COSMOS-LYX/DuctANC/实验记录/20261110_205912_p4prep/report.md

# P4 准备：固件 0.3 已编译，第 2、3 步没有上板

日期：2026-11-10 20:59。喇叭没有出声，没有发 `TONE` / `NOISE` / `SWEEP`。声学上的 DAC→误差麦延迟（P2 的 5–6 个样本）这次没有测，那一步要喇叭响，等确认接线后再做。

## 做到哪一步

1. 编译和离线测试做完了。`firmware/hwtest` 的 debug 预设能链出 `hwtest.elf`。`host` 里 `pytest test_hwtest.py` 是 19 项通过；加上面那个 `XCHK` 拒绝之后又跑了一次，仍是 19 项通过。算法形式没有改：N=16，更新是减号，ε=1，二阶 80 Hz 因果高通的系数和 P3 同一组 float32 位型，Ŝ 用 `实验记录/20261110_175018_p2shat/shat.npz` 的 `h_err`，在上位机卷上高通冲激响应后截成 384 阶。开机 μ=0.002，γ=0，默认限幅 ±40 码。
2. 数值对账（同一段参考麦码、同一只 Ŝ_eff，上位机 x' 对固件回传的 x'）没有做。
3. 静音时的 CPU / 时序（`CLAMP 0`，ANC 开着但 DAC 停在中点，并在 `CAP` 回传时再读一次 `slip` / `lag_us`）没有做。

卡在链路上，不是卡在算法。

## 烧录

第一次 `cmake --build --preset debug --target flash` 成功：ST-LINK 序列号 37FF71064E57343665F41043，目标电压 3.27 V，器件 ID 0x413，下载 `hwtest.elf` 后校验通过，并做了软件复位。那一版就是当时源码，版本字符串 `duct-anc-hwtest-0.3`。

之后只加了一个口子：`XCHK` 在 ANC 已经开着时，先回 `ERR xchk anc on`，不再先读那一段二进制。源码重新编译通过（Flash 44500 B，RAM 45880 B，CCMRAM 64000 B）。再烧的时候 STM32CubeProgrammer 报 `No ST-Link detected`，用 `-l` 再看一次，ST-Link、J-Link、DFU 都是空的。所以芯片里现在仍是第一次校验通过的那一版；源码比芯片多这一个 `XCHK` 拒绝。第 2 步本来就会先 `ANC OFF` 再 `XCHK`，两版在这条路径上一样。

## 蓝牙

复位之后没有再对板子说过话。`python hwtest.py ports` 能看到口，但带真实蓝牙地址的口打不开：

| 口 | 结果 |
| --- | --- |
| COM16（此前用来传出的口，地址 58565FA3EC67） | 打开失败，信号灯超时（Win32 121） |
| COM8（CCFF9041D81F）、COM14（260909B603FA） | 同样是信号灯超时 |
| COM4 / COM7 / COM15 / COM17（地址全 0） | 本地能打开。对 COM4 发了一次 `PING`，没有返回，进程挂住后已结束 |

这是 SPP 没连上，不是固件没应答。`INFO` 里的版本字符串这次没有读到。

## 第 2、3 步准备好但没跑的内容

`host/anc_p4.py` 的 `both`：先 `ANC OFF`，再按 48 段把 Ŝ_eff 送上去并核对 CRC；用 `4_stand` 前 400 个参考麦码做 `XCHK`，和上位机同一套 float32 递推比最大绝对误差。然后 `CLAMP 0`、`MU 0.002`、`GAMMA 0`、`ANC ON`，连做三次 2000 帧带 DAC 的 `CAP`，每次前后读 `ANC STATUS`。通过条件是 `late=ovr=udr=slip=0`、`cpu` < 50%，并且每一格 DAC 码都是 2048。`cpu` 若一直是 0 而样本数在涨，记成 DWT 没在走，不当成占用率真是 0。`slip` 的门槛是 DAC 中断之后超过两个采样周期（250 µs）才把空出来的那一格写上；`late` / `udr` 仍保留，它们看不到「DAC 只是重复了旧码」这一种晚一拍。

这些数字这次都没有。

## 后面开环之前的操作顺序

保护用的开环基线是 ANC 关着时、误差麦高通后 50 ms RMS 的慢跟踪，门槛是它的 2 倍。基线会写在 `ANC ON` 和 `ANC STATUS` 的 `baseline=` 里。闭环时要先让手机的 200 Hz 响几秒，再 `ANC ON`。基线只有几 mV 时不要先开 ANC 再放手机，那 0.3 s 里保护会清 W。这次没有把「基线太小就拒绝 ANC ON」写进固件：第 3 步要在安静房间里开着 ANC、输出强制为 0 来量 CPU。

声学延迟要在喇叭可以响之后，用 `CAP` 多测几次。有时 5 有时 6 就先查时序，再谈降噪。`lag_us` 不能代替这个样本数。
