COSMOS-LYX/DuctANC/实验记录/20261110_210253_p4prep/report.md

# P4 第 1–3 步

固件 duct-anc-hwtest-0.3，端口 COM16。喇叭指令没有发。

这一次的 x' 误差不能用。上位机按 `\r\n` 发命令，固件读到 `\r` 就结束，把 `\n` 留在接收缓冲里。`XCHK` 接着把这个 `\n` 当成了第一个数据字节，400 个码整体错开 1 字节，所以回传的数到了 10^5。CPU 测试没跑成：下一次 `SHAT RST` 被剩下的那个字节粘成了未知命令。

## x' 对账

Ŝ_eff 校验 143A81AB。高通冲激响应留了 128 点（尾部能量 9.60e-07）。和在线 biquad 比，200 Hz 差 -0.0149 dB、+0.0054°。

400 点参考麦码：固件减上位机，最大绝对误差 5.259e+05，最大相对误差 1.583e+04，rms 2.537e+05。
