COSMOS-LYX/DuctANC/实验记录/20261110_210931_p4prep/report.md

# P4 第 1–3 步

固件 duct-anc-hwtest-0.3，端口 COM16。喇叭指令没有发。

## x' 对账

Ŝ_eff 校验 143A81AB。高通冲激响应留了 128 点（尾部能量 9.60e-07）。和在线 biquad 比，200 Hz 差 -0.0149 dB、+0.0054°。

400 点参考麦码：固件减上位机，最大绝对误差 0.000e+00，最大相对误差 0.000e+00，rms 0.000e+00。

## CPU 和时序（CLAMP 0，DAC 应保持 2048）

| 次序 | cpu % | lag_us | slip | late | ovr | udr | prot | baseline |
| --- | ---: | ---: | ---: | ---: | ---: | ---: | ---: | ---: |
| 0 | 35.1 | 10 | 0 | 0 | 0 | 0 | 0 | 162.17 |
| 1 | 35.8 | 12 | 0 | 0 | 0 | 0 | 1 | 162.17 |
| 2 | 34.1 | 12 | 0 | 0 | 0 | 0 | 1 | 162.17 |
| 3 | 34.1 | 12 | 0 | 0 | 0 | 0 | 1 | 162.17 |

| CAP | dac 不是 2048 的帧 | min | max |
| --- | ---: | ---: | ---: |
| 0 | 0 | 2048 | 2048 |
| 1 | 0 | 2048 | 2048 |
| 2 | 0 | 2048 | 2048 |

cpu 是两次 STATUS 之间最慢一拍占采样周期的百分比。lag_us 是 DAC 中断到任务写槽的最大时间，超过 250 µs 会计 slip。
这三次 CAP 串口在传数据。DAC 列如果出现不是 2048 的码，说明限幅没有把输出按在中点。
DAC 到误差麦的到达样本数这次没测：那要喇叭出声。`lag_us` 是任务把码写进 DMA 槽的时间，不能代替这个样本数。

## 怎么读这些数

x' 对上位机 float32 逐点相同，400 点里最大绝对误差是 0。这是同一套运算顺序对上了，不是放宽门槛之后才过。Ŝ_eff 的 CRC 是 143A81AB。高通截成 128 点再卷积，相对在线 biquad，200 Hz 差 −0.015 dB、+0.005°，这是系数近似，已经含在上面那次逐点比较里。

三次 CAP 期间串口都在传数据。最慢一拍 CPU 34%–36%，低于 50%。`lag_us` 是 10、12、12、12，`slip`、`late`、`ovr`、`udr`、`rxovf` 都是 0。三次写槽时间都在 12 µs 上下，没有出现有时一拍、有时两拍那种抖动。DAC 三列全部是 2048，喇叭指令没有发。

保护在第一次 CAP 回传之后锁上了。开 ANC 时基线已经是 162 mV（门槛 324 mV），不是几 mV。锁上之前误差麦 50 ms RMS 是 93 mV，200 Hz 是 14 mV；锁上时固件报的最后一窗是 493 mV，200 Hz 仍是 15 mV。存下来的三段各 0.25 s 里，误差麦 RMS 只有 80–85 mV，50 ms 窗都在 65–99 mV。493 mV 落在采完之后、串口把 12000 字节送出去的那一秒里，CAP 缓冲里没有这段波形。不确定是蓝牙发送时耦进误差麦，还是管子上真有一下冲击。阈值没有改。锁上之后 W 被清成 0，后面两段 CPU 仍含 384 点 FIR。

测完已经 `ANC OFF`，保护标志清掉，`CLAMP` 设回 40。结束时基线约 25 mV，误差麦 200 Hz 约 1 mV。闭环仍要先让手机的 200 Hz 响几秒，再 `ANC ON`。

板子上跑的是第一次校验烧进去的 0.3。`XCHK` 这次只以 `\n` 结尾。源码里已经让 getline 把 `\r\n` 收成一次换行，但 ST-Link 不在，这版还没烧进去。`实验记录/20261110_210253_p4prep` 是错位那一次，数字作废。
