COSMOS-LYX/DuctANC/实验记录/20261110_211546_p4prep/report.md

# P4 第 1–3 步

固件 duct-anc-hwtest-0.3，端口 COM16。喇叭指令没有发。

## x' 对账

Ŝ_eff 校验 143A81AB。高通冲激响应留了 128 点（尾部能量 9.60e-07）。和在线 biquad 比，200 Hz 差 -0.0149 dB、+0.0054°。

400 点参考麦码：固件减上位机，最大绝对误差 0.000e+00，最大相对误差 0.000e+00，rms 0.000e+00。

## CPU 和时序（CLAMP 0，DAC 应保持 2048）

| 次序 | cpu % | lag_us | slip | late | ovr | udr | prot | baseline |
| --- | ---: | ---: | ---: | ---: | ---: | ---: | ---: | ---: |
| 0 | 34.4 | 12 | 0 | 0 | 0 | 0 | 0 | 25.49 |
| 1 | 35.6 | 12 | 0 | 0 | 0 | 0 | 0 | 25.49 |
| 2 | 35.6 | 12 | 0 | 0 | 0 | 0 | 0 | 25.49 |
| 3 | 35.6 | 12 | 0 | 0 | 0 | 0 | 0 | 25.49 |

| CAP | dac 不是 2048 的帧 | min | max |
| --- | ---: | ---: | ---: |
| 0 | 0 | 2048 | 2048 |
| 1 | 0 | 2048 | 2048 |
| 2 | 0 | 2048 | 2048 |

cpu 是两次 STATUS 之间最慢一拍占采样周期的百分比。lag_us 是 DAC 中断到任务写槽的最大时间，超过 250 µs 会计 slip。
这三次 CAP 串口在传数据。DAC 列如果出现不是 2048 的码，说明限幅没有把输出按在中点。
DAC 到误差麦的到达样本数这次没测：那要喇叭出声。`lag_us` 是任务把码写进 DMA 槽的时间，不能代替这个样本数。

## 这次烧进去的是什么

ST-LINK 37FF71064E57343665F41043，3.29 V，下载校验通过并软件复位。芯片里现在有 getline 的修改：命令以 `\r\n` 结尾时，`\n` 不再留在接收缓冲里。上位机的 `XCHK` 已改回走普通的 `\r\n`。这次对账就是用 `\r\n` 做的，400 点最大误差仍是 0。`rxovf` 是 0。

静音时序和上一轮一致：CPU 34%–36%，写槽 12 µs，三次一样，`slip`/`late`/`ovr`/`udr` 都是 0，DAC 全是 2048。基线 25.5 mV，误差麦 23–30 mV，200 Hz 约 3 mV。三次 CAP 回传期间保护没有锁。上一轮那次 493 mV 没有复现；至少这一轮，串口送数本身没有把误差麦推过门槛。

`‖W‖` 从 0.14 增到 0.78。`CLAMP 0` 把输出按在中点，更新仍在跑，误差麦不是 0，所以 W 会慢慢长。这是开环，不是喇叭在响。`clamp_n` 一直在涨，是因为限幅为 0 时只要 y 不是整数 0 就算碰上。测完已经 `ANC OFF`，W 是 0。限幅已设回 ±40，状态行读到 `clamp=40.0`、`on=0`、`prot=0`。
