COSMOS-LYX/DuctANC/实验记录/20261110_212253_p4delay/report.md

# 作废的一次

只采完第一段，到达是 5，DAC rms 35.5 码，200 Hz 相干 0.973。第二段回传少了 2 个字节，尾部变成 `ND 03E9EA51`。当时已经 `STOP`。正式的三次在 `20261110_212446_p4delay`。
