COSMOS-LYX/DuctANC/实验记录/20261110_212446_p4delay/report.md

# DAC→误差麦到达样本

ANC 全程 OFF。激励 `NOISE 0.03`，和 P2 相同。每段 10666 帧，带 DAC。测完已 `STOP`。

Ŝ 的 `h_err` 用同一条规则（|h| 第一次超过峰值 30%）落在第 5 个样本。P2 记录里写的 5–6，是这个上升沿：第 4 点还只有峰值的 1.5%，第 5 点 32%，第 6 点 54%。

| 次 | 到达 | |h| 最大 | DAC rms | 200 Hz 相干 | cpu % | slip | late | ovr | udr | baseline |
| --- | ---: | ---: | ---: | ---: | ---: | ---: | ---: | ---: | ---: | ---: |
| 0 | 5 | 28 | 35.7 | 0.758 | 33.9 | 0 | 0 | 0 | 0 | 394.49 |
| 1 | 5 | 28 | 35.2 | 0.898 | 33.9 | 0 | 0 | 0 | 0 | 396.59 |
| 2 | 5 | 42 | 35.5 | 0.843 | 34.1 | 0 | 0 | 0 | 0 | 407.68 |

到达样本数：5、5、5。三次相同。

前 12 个系数（mV/码）：

- 第 0 次：-0.104 -0.064 +0.023 +0.079 +0.091 +0.570 +0.898 +1.052 +0.605 +0.533 +0.065 +0.183
- 第 1 次：+0.030 +0.058 +0.081 +0.048 +0.046 +0.461 +0.802 +0.990 +0.527 +0.590 +0.220 +0.358
- 第 2 次：+0.041 -0.007 -0.040 +0.031 +0.107 +0.489 +0.730 +0.999 +0.583 +0.581 +0.048 +0.119
- Ŝ：+0.007 +0.008 +0.008 +0.007 +0.023 +0.467 +0.799 +1.031 +0.568 +0.563 +0.145 +0.230

开噪声前：on=0 clamp=40.0 wnorm=0.0000 baseline=155.04 e200=20.28 cpu=33.4 slip=0 late=0 ovr=0 udr=0

计数器是累积值。cpu 是上一次 STATUS 之后最慢一拍占采样周期的百分比，所以每一行盖住这一次采集和回传。

STOP 后约 3 秒：on=0 wnorm=0.0000 clamp=40.0 baseline=205.68 prot=0 slip=0 late=0 ovr=0 udr=0 cpu=32.6。基线还在从噪声档往回落。又过了一会儿读到 baseline=155.65，和开噪声前的 155 一样。此时 err_rms=202，e200=21，on=0，out=OFF，slip=late=ovr=udr=0，cpu=32.6，lag_us=11。

没有发 `ANC ON`。

200 Hz 相干是 0.76、0.90、0.84。P2 那三段在 200 Hz 是 0.96–0.98。到达下标没有因此改变。第三次 |h| 的最大值从第 28 点移到第 42 点，上升沿仍在第 5 点。
