COSMOS-LYX/DuctANC/实验记录/20261110_213549_p4try/report.md

# 10 s 闭环试一次

开环：误差麦 200 Hz 192.46 mV，参考麦 200 Hz 43.72 mV，基线 205.64 mV。
允许范围是 153 mV、32 mV 的 ±20%，也就是 122–184 mV 和 26–38 mV。

没有打开 ANC。

误差麦比 153 mV 高 26%，参考麦比 32 mV 高 37%。两路一起偏高，比值 192/44 ≈ 4.4，P0 是 153/32 ≈ 4.8。紧接着又读了一次：误差麦 184 mV、参考麦 40 mV，仍在 ±20% 以外。基线 206 mV。on=0，prot=0，slip=late=ovr=udr=0。
