COSMOS-LYX/DuctANC/实验记录/20261110_214041_p4try/report.md

# 10 s 闭环试一次

开环：误差麦 200 Hz 5.96 mV，参考麦 200 Hz 2.21 mV，比值 2.70，基线 79.79 mV，保护门槛 159.58 mV。
通过条件：误差麦 100–260 mV，参考麦 25–60 mV，比值 3.8–5.8。

没有打开 ANC。误差麦 6.0 mV 低于 100 mV，参考麦 2.2 mV 低于 25 mV，比值 2.70 也低于 3.8。

紧接着又读了一次：误差麦 5.9 mV，参考麦 3.0 mV，基线 85 mV。on=0，prot=0，slip=late=ovr=udr=0。
