COSMOS-LYX/DuctANC/实验记录/20261110_214141_p4try/report.md

# 10 s 闭环试一次

开环：误差麦 200 Hz 195.86 mV，参考麦 200 Hz 43.02 mV，比值 4.55，基线 218.31 mV，保护门槛 436.62 mV。
通过条件：误差麦 100–260 mV，参考麦 25–60 mV，比值 3.8–5.8。

μ=0.005，γ=0，限幅 ±40。

| t / s | e200 | r200 | yrms | wnorm | clamp_n | prot | cpu | slip | late | ovr | udr |
| ---: | ---: | ---: | ---: | ---: | ---: | ---: | ---: | ---: | ---: | ---: | ---: |
| 0.07 | 186.24 | 46.30 | 7.56 | 0.0509 | 0 | 0 | 35.2 | 0 | 0 | 0 | 0 |
| 0.55 | 31.74 | 52.16 | 14.60 | 0.0567 | 73 | 0 | 34.5 | 0 | 0 | 0 | 0 |

0.55 s 时限幅计数从 0 增到 73，按约定立刻 `ANC OFF`。没有重试，参数没有改。没有跑满 10 s，上面两行不能取中位数当稳态。

开前误差麦 200 Hz 195.86 mV。关掉前最后一读 31.74 mV，低了 15.8 dB，出现在约 0.5 s。这一读没有再保持，所以不算稳态。prot=0，clamp_n=73，slip=late=ovr=udr=0。y rms 14.6 码，半秒里有 73 个样本碰到 ±40。

关掉之后：on=0，prot=0，W 已清零，e200 仍显示 31.74（0.25 s 窗还没换），baseline=223.15。
