COSMOS-LYX/DuctANC/实验记录/20261110_214925_p4run3/report.md

# μ=0.002 的 3 s

开环：误差麦 200 Hz 72.92 mV，参考麦 200 Hz 25.87 mV，比值 2.82，基线 366.56 mV，保护门槛 733.12 mV。

没有打开 ANC。误差麦 73 mV 低于 100 mV，比值 2.82 低于 3.8。参考麦 26 mV 落在 25–60 mV 里。基线 367 mV，门槛 733 mV。

关掉之后：on=0 prot=0 e200=72.92 baseline=370.56。
