COSMOS-LYX/DuctANC/实验记录/20261110_215257_p4demo/report.md

# 一次演示，没有预检、没有因限幅提前停

开环：误差麦 200 Hz 270.93 mV，参考麦 53.99 mV，基线 360.39 mV。
μ=0.005，γ=0，限幅 ±40。计划开 8 s。

| t / s | e200 | r200 | yrms | clamp_n | prot | cpu | slip | late | ovr | udr |
| ---: | ---: | ---: | ---: | ---: | ---: | ---: | ---: | ---: | ---: | ---: |
| 0.04 | 270.93 | 53.99 | 7.90 | 14 | 0 | 34.5 | 0 | 0 | 0 | 0 |
| 0.30 | 191.41 | 74.68 | 16.48 | 195 | 0 | 35.2 | 0 | 0 | 0 | 0 |
| 0.55 | 93.66 | 61.82 | 19.41 | 431 | 0 | 34.4 | 0 | 0 | 0 | 0 |
| 0.83 | 108.93 | 67.52 | 19.53 | 634 | 0 | 34.4 | 0 | 0 | 0 | 0 |
| 1.05 | 56.88 | 69.81 | 18.34 | 734 | 0 | 35.2 | 0 | 0 | 0 | 0 |
| 1.32 | 62.82 | 61.17 | 18.75 | 944 | 0 | 35.1 | 0 | 0 | 0 | 0 |
| 1.55 | 36.35 | 71.92 | 18.20 | 1090 | 0 | 35.2 | 0 | 0 | 0 | 0 |
| 1.80 | 43.30 | 71.05 | 17.73 | 1192 | 0 | 35.2 | 0 | 0 | 0 | 0 |
| 2.07 | 82.08 | 61.84 | 19.66 | 1427 | 0 | 35.2 | 0 | 0 | 0 | 0 |
| 2.30 | 86.67 | 58.93 | 19.43 | 1648 | 0 | 34.5 | 0 | 0 | 0 | 0 |
| 2.55 | 87.50 | 67.88 | 19.44 | 1828 | 0 | 35.2 | 0 | 0 | 0 | 0 |
| 2.81 | 75.55 | 64.20 | 20.13 | 2043 | 0 | 35.2 | 0 | 0 | 0 | 0 |
| 3.05 | 111.15 | 58.76 | 19.34 | 2273 | 0 | 35.2 | 0 | 0 | 0 | 0 |
| 3.31 | 55.94 | 68.70 | 16.72 | 2386 | 0 | 34.4 | 0 | 0 | 0 | 0 |
| 3.56 | 67.68 | 67.65 | 17.48 | 2561 | 0 | 35.2 | 0 | 0 | 0 | 0 |
| 3.83 | 82.58 | 60.46 | 18.82 | 2757 | 0 | 35.8 | 0 | 0 | 0 | 0 |
| 4.03 | 39.71 | 72.58 | 18.16 | 2965 | 0 | 35.2 | 0 | 0 | 0 | 0 |
| 4.30 | 52.97 | 79.61 | 18.65 | 3128 | 0 | 35.9 | 0 | 0 | 0 | 0 |
| 4.55 | 48.00 | 76.32 | 17.87 | 3403 | 0 | 35.2 | 0 | 0 | 0 | 0 |
| 4.80 | 47.59 | 70.80 | 19.72 | 3559 | 0 | 34.4 | 0 | 0 | 0 | 0 |
| 5.07 | 33.66 | 84.48 | 21.20 | 3774 | 0 | 35.2 | 0 | 0 | 0 | 0 |
| 5.32 | 115.90 | 58.43 | 17.74 | 4020 | 0 | 34.4 | 0 | 0 | 0 | 0 |
| 5.56 | 33.19 | 71.37 | 19.50 | 4223 | 0 | 35.2 | 0 | 0 | 0 | 0 |
| 5.82 | 67.64 | 75.96 | 17.12 | 4357 | 0 | 35.2 | 0 | 0 | 0 | 0 |
| 6.06 | 59.76 | 60.56 | 18.71 | 4552 | 0 | 35.9 | 0 | 0 | 0 | 0 |
| 6.28 | 85.96 | 60.67 | 20.71 | 4730 | 0 | 34.4 | 0 | 0 | 0 | 0 |
| 6.55 | 124.11 | 80.25 | 19.41 | 5002 | 0 | 34.4 | 0 | 0 | 0 | 0 |
| 6.81 | 33.06 | 72.78 | 22.27 | 5228 | 0 | 35.2 | 0 | 0 | 0 | 0 |
| 7.05 | 107.77 | 68.90 | 18.98 | 5431 | 0 | 34.5 | 0 | 0 | 0 | 0 |
| 7.31 | 55.33 | 69.42 | 20.87 | 5571 | 0 | 35.2 | 0 | 0 | 0 | 0 |
| 7.55 | 110.87 | 61.46 | 20.83 | 5725 | 0 | 35.2 | 0 | 0 | 0 | 0 |
| 7.83 | 84.11 | 63.95 | 19.22 | 5931 | 0 | 34.4 | 0 | 0 | 0 | 0 |
| 8.06 | 35.21 | 73.54 | 20.30 | 6084 | 0 | 34.4 | 0 | 0 | 0 | 0 |

末 2 s 的 0.25 s 读数在 33–124 mV 之间来回跳，中位数 84 mV，相对开前 271 mV 低 10.2 dB。最低的一窗是 33 mV（约 18 dB），没有停在那里。第一次低于开环 3 dB 是在约 0.3 s，之后又多次回到 100 mV 以上。

8 s 里限幅计数从 0 增到 6084，大约每 10 个样本有 1 个碰到 ±40，不是只在开头。开头 1.33 s 的 970 个也从 48 ms 分布到 1.30 s。y 的 200 Hz 分量是 8.5 码 rms；133、230、400 Hz 都在 0.6 码以下。这段频谱只覆盖开头 1.33 s。
末次 prot=0 clamp_n=6084 slip=0 late=0 ovr=0 udr=0 cpu=34.4。

开头 1.33 s 的 DAC：碰到 ±40 的样本 970 个。
第一个 48 ms，最后一个 1299 ms。

| 频率 | 这段 y 的 rms / 码 |
| ---: | ---: |
| 200 Hz | 8.51 |
| 133 Hz | 0.54 |
| 230 Hz | 0.51 |
| 400 Hz | 0.31 |

关掉之后 on=0 prot=0 e200=289.24。
