COSMOS-LYX/DuctANC/02_讨论记录.md

# 讨论记录

## 待决问题

| # | 问题 | 状态 |
| --- | --- | --- |
| Q1 | 学校的毕设任务书指标是什么？是否沿用课程设计的「100–400 Hz、≥10 dB、FreeRTOS、自画 PCB ≤100×100」 | 待确认 |
| Q2 | 原仓库 `COSMOS-LYX/duct-anc-stm32` 是否作为代码基础拉进本文件夹 | 待确认 |
| Q3 | 手头有哪些测量设备：声级计 / 测量麦 / 声卡 / 示波器 | 待确认 |
| Q4 | 「通风口」是否指真实场景（更大截面、更大风量），还是沿用 Φ75 实验管 | 待确认 |
| Q5 | 毕设加深项选哪几个（见 `01_设计评估.md` 第 3 节） | 待讨论 |
| Q6 | 时间节点：开题、中期、答辩日期 | 待确认 |

## 决策记录

| 日期 | 决策 | 理由 |
| --- | --- | --- |
| 2026-11-08 | 以原课程设计架构（STM32F407 + FxNLMS 前馈）为基础 | 架构核对成立，见评估第 1 节 |
| 2026-11-08 | 控制板用 F407VET6 黑色最小系统板，固件用 StdPeriph 标准库 + FreeRTOS，CMake + CubeCLT GCC 编译 | 用户指定；本机只装了 CubeCLT |
| 2026-11-08 | 上位机通信走 JDY-31 蓝牙 SPP（USART1 PA9/PA10，9600） | 用户指定；采集原始数据受 9600 限制，可改 115200 |
| 2026-11-10 | 蓝牙改 115200：固件开机时在未连接状态下用 AT 指令自动把 JDY-31 从 9600 改成 115200 | 4000 帧采集从 17 s 降到约 1.5 s；不需要 USB-TTL |
| 2026-11-10 | 初级噪声源改用外部声源（手机外放），不再用风扇；第一阶段目标：误差麦处 200 Hz 单音衰减 ≥10 dB | 手机单音频率稳定、可复现；此前记录里「风扇」段实际是否开过风扇已无法确认 |
| 2026-11-10 | 第一阶段继续用参考麦。200 Hz 回路放大倍数 0.34 | 抵消档回流 10.8 mV，手机在参考麦上 32 mV。最坏同相叠加约 1.5 倍。见 `实验记录/20261110_173557_fb200` |
| 2026-11-10 | P4 的控制只动 200 Hz 附近：参考先窄带通，或控制抽头别太多 | 单音任务。Ŝ 在 133 Hz 和 232 Hz 各有一峰，350 Hz 是深凹陷，宽带自由适应会碰到变化很大的次级路径 |
| 2026-11-10 | Ŝ 用 17:00 三段白噪声、384 阶、单位 mV/DAC 码 | 留出验证的带内 NMSE 约 −18 dB，三段冲激响应互差约 −31 dB，并能预测随后的 200 Hz 单音。见 `实验记录/20261110_175018_p2shat` |
| 2026-11-10 | 这一阶段的相干合格线改成 200 Hz 附近 >0.9 | 100–400 Hz 平均只有 0.84，被 350 Hz 推不动的那段拉低；200 Hz 本身是 0.98 |
| 2026-11-10 | 现在这只 Ŝ 不含 80 Hz 高通；P4 烧录前要和固件用同一只因果高通 | 回归只去了直流。二阶 Butterworth、80 Hz、8 kHz 在 200 Hz 有 +34°，一阶是 +22° |
| 2026-11-10 | P4 控制器先用 N=16、μ=0.005、γ=0、二阶 80 Hz 因果高通并卷进 Ŝ，DAC 限幅 −2048…2047 | 离线仿真在回流、高通、整数量化都加上之后，200 Hz 长时拟合约 −48 dB、0.25 s 窗约 −31 dB，0.4 s 收敛。μ=0.015 起顶满 DAC。见 `实验记录/20261110_195059_p3sim` |
| 2026-11-10 | 固件 0.3 按这个形式逐样本跑 FxNLMS；开机 μ=0.002、限幅 ±40；喇叭先不开 | 第 1 步编译和 pytest 已过，第一版已校验烧入。x' 对账和静音 CPU 还没做，蓝牙和 ST-Link 随后都断开了。见 `实验记录/20261110_205912_p4prep` |
| 2026-11-10 | 第 2、3 步按实测收：x' 逐点相同，静音时 CPU 约 35%，写槽约 12 µs；喇叭仍不开 | 400 点最大误差是 0。三次 CAP 期间 slip/late/ovr/udr 都是 0，DAC 全是 2048。保护在回传时锁上过，阈值没改。见 `实验记录/20261110_210931_p4prep` |
| 2026-11-10 | `\r\n` 由固件收成一次换行，这版已烧进芯片 | 否则 `XCHK` 会把 `\n` 当成数据，码错开 1 字节。烧入后用 `\r\n` 复测，误差仍是 0。见 `实验记录/20261110_211546_p4prep` |

## 讨论日志

### 2026-11-08

- 建立讨论文件夹，完成第一版架构评估。
- 评估要点：高风险是相干性、声反馈、风扇旁路辐射/测量方法；中风险是抗混叠、因果余量、驻波、功放增益匹配。
- 建议第一个实验：风扇开、ANC 关，录参考麦和误差麦，计算 100–400 Hz 频谱与相干函数。
- PVC 管实验平台已搭好（参考麦 → 扬声器 → 误差麦）。
- 新建 `firmware/hwtest` 基础硬件测试固件和 `host/hwtest.py` 上位机：蓝牙 PING、扬声器单音/噪声/扫频、麦克风电平与原始数据采集、一键自检。编译通过（Flash 36 KB，RAM 38 KB，CCM 64 KB 采集缓冲），上位机用模拟固件离线测试通过，**尚未上板**。
- 上板后用 `capture` 在风扇开时采一段，就能得到建议的第一个实验（频谱 + 相干函数）。
- 首次上板自检（`实验记录/20261108_165459_selftest`）：蓝牙、时钟、ADC/DAC 正常。发现两个硬件问题：
  1. err 通道 ≈ 0.69×ref + 356，相关 0.996、滞后 0 样本、全频段相干≈1 → 不是声音，是 PC1 悬空时 ADC 扫描串扰（误差麦没有真正接到 PC1）。
  2. ref 麦在「静音」段也在 0~4095 之间满幅削波，主要成分 128/324 Hz → 麦克风饱和（风扇开着、增益过高或气流直吹）。
- 自检脚本加入「静音电平」「两路独立」两项检查和关风扇提示。
- 喇叭嗡嗡声：PAM8403 的 MUTE/SHDN 接 VCC、INR 接地后，换成稳定电源，嗡嗡声明显减小，用户认为可以接受。后续若影响降噪下限再处理（单独供电 + 输入分压）。
- 首次 mictest（`实验记录/20261108_184511_mictest`）：
  - 通道顺序和几何正确：GCC-PHAT 测得喇叭声 err 比 ref 早 4 样本（应 3），风扇声 err 晚 8 样本（应 10，约 343 mm）。敲击测试的 FAIL 是指标设计问题（按相对 dB 比较，本底高的 ref 天然吃亏），改为绝对增量并降为参考项。
  - 喇叭白噪声 amp 0.1 时两只麦都削波 → 两只麦对管内平面波灵敏度相近（100–400 Hz 分别 1279/1084 mV）。mictest 默认 amp 改为 0.02。
  - **「静音」和「风扇」两段几乎一样**：ref 在 100–400 Hz 分别 79/83 mV，err 11/10 mV，主峰都是 125 Hz 和 320 Hz。要么第 1 步风扇没真正断电，要么这只风扇在 100–400 Hz 几乎不出声，待确认。
  - ref 的 125/320 Hz 比 err 高约 18 dB，而对喇叭声两只麦灵敏度相近 → 这部分不是沿管道传播的平面波，是 ref 麦附近的局部干扰（风扇近场/湍流/振动，或电气耦合），γ²≈0.5 也与此一致。
  - err 有 4–30 Hz 的次声成分（约 25 mV），在目标频段之外，不影响 ANC。
- 第二次 mictest（`实验记录/20261108_190027_mictest`）：
  - 喇叭白噪声 amp 从 0.1 降到 0.02（−14 dB）：err 100–400 Hz 从 1084 降到 390 mV（正常），ref 仍然削波（1192 mV）。声程差变成 err 比 ref **晚** 10 样本，与几何相反。解释：喇叭信号以电气方式直接耦合进 ref 麦电路（零延迟），err 收到的是走管道的声音（约 0.7 ms 加喇叭延迟）。
  - ref 静音时 125/320 Hz 约 81 mV，err 只有约 8 mV → 同一来源：功放残余噪声电气耦合进 ref（地线共用或走线挨着喇叭线/功放）。
  - 风扇在 100–400 Hz 很弱：开风扇后 err 只从 8 mV 升到 11 mV（风扇本身约 7.5 mV），比 amp 0.02 的喇叭声低约 34 dB。待确认风扇供电电压。
- 新增 `hwtest.py mictest` 麦克风专项测试：本底噪声 → 敲击定位 → 扬声器白噪声 → 风扇噪声，输出信噪比、削波、相干性（降噪上限）和 GCC-PHAT 声程差（核对通道和几何）。

### 2026-11-10

- 功放改电池单独供电，开发板和麦克风留在 USB 上，地线单点连接，之后参考麦底噪明显下降（`实验记录/20261109_170228_mictest`）。
- 那次的「3_fan」段实际是**手机外放 200 Hz 单音**；之前记录里的「风扇」段有没有真的开风扇，已经记不清。之后统一改用外部声源。
- 复核 `20261109_170228_mictest`：
  - 单音频率实测 199.95–200.07 Hz，两麦相干 1.00；400 Hz 处相干 0.96。脚本给出的「平均相干 0.26」把没有信号的频点也平均进去了，不能用。
  - 200 Hz 处参考麦比误差麦高约 25 dB（49.9 vs 25.0 dB），而喇叭白噪声下两麦灵敏度相近 → 手机离参考麦太近，参考麦在近场。参考麦 rms 776 mV，600 Hz 三次谐波只比基波低 17.6 dB，可能是手机喇叭失真或参考麦接近饱和。
  - 单音每 5 ms 重复一次，GCC-PHAT 给出的「0 样本」延迟没有意义。
  - 误差麦 80 Hz 以下 rms：静音 24 mV，播放单音时 167 mV，约占误差麦总能量的 88%（80 Hz 二阶高通后总 rms 从 179 mV 降到 63 mV）。疑似来源：手机碰管/手扶的振动、短音频循环处的咔哒声、管口气流扰动，待对照。
  - 喇叭白噪声 amp 0.02 时参考麦仍削波 38%，延迟 +9 而非 −3，与 11-08 的「喇叭驱动电耦合进参考麦」判断一致，尚未排除。
- 固件现状对后续的影响：
  - `CAP` 不记录 DAC 输出，噪声发生器自由运行，离线辨识 Ŝ 前需要同步录 DAC。
  - `AUDIO_BLK = 128`，ADC→DAC 有 128–256 样本（16–32 ms）延迟。对单音可以接受，Ŝ 必须覆盖这段延迟；宽带 ANC 必须改成小块处理。
  - 误差信号加高通时，用高通后的误差麦数据辨识 Ŝ，让 Ŝ 自带高通。
- 下一步：
  - P0：手机用支架固定、不碰管、音量降到参考麦 rms 200–300 mV，播放长的无缝音频；做贴管/不贴管、播放静音文件两组对照，查低频脉冲来源；喇叭降到不削波后拔线对照，确认参考麦电串扰。
  - P1：`CAP` 增加 DAC 通道（可选：波特率提到 115200）。
  - P2：离线辨识 Ŝ。
  - P3：Python 离线仿真 FxLMS。
  - P4：固件 200 Hz FxLMS（小块处理、80 Hz 高通、32 抽头 NLMS、泄漏、限幅、发散保护）。
  - P5：ANC 开/关交替验收。
- 第一次 p0test（`实验记录/20261110_102735_p0test`）：
  - 参考麦电串扰排除：拔喇叭线 / 关功放后两路 300 Hz 都掉到本底（ref −57 / −60 dB）。11-08 的「喇叭驱动电耦合进参考麦」不成立，ref 削波和 +9 延迟是声学原因。
  - 4–6 段出现与固件 128 样本块（16 ms）同步的跳变 + 800 Hz（fs/10）谐波，0–3 段没有，出现在「恢复功放和喇叭接线」之后。11-08 最早几次记录里也有同样的同步干扰。判断为接线/地线接触相关，不是手机。p0test 已加「MCU 同步干扰」检查（块内位置折叠 |diff|，边界/其余 ≥2 倍判定）。
  - 手机音量过大（ref 990 mV 削波），声源段数据作废。
- 麦克风模块对调（`实验记录/20261110_121744_p0test`）：只对调两块 MAX4466 模块，线不动（PC0 仍是参考位置）。记原参考位置那块为 M1，原误差位置那块为 M2。
  - 喇叭 300 Hz 的 ref−err：对调前 +22.5 dB，对调后 −16.0 dB。由两次各自的两路比值算出：**M1 比 M2 灵敏约 19 dB**（模块本身），参考位置比误差位置多收约 3 dB（位置）。本底差值也跟着模块走（+19 → −20 dB）。
  - 低频也跟着 M2 走：静音段 80 Hz 以下，M2 在误差位置时 26.6 mV、在参考位置时 18.5 mV；M1 在两处都约 3 mV。M2 增益低 19 dB 却低频大 8 倍，M2 模块（或它的接头）本身有问题。
  - 同步干扰这次消失（重新插过杜邦线），进一步说明与接触/接线有关。
- 决策：保持对调后的布置——M2（低灵敏度、低频噪声大）作参考麦，M1（高灵敏度、低频干净）作误差麦。参考麦不再容易削波，误差麦分辨率更高、低频干净，利于自适应。之后不再动麦克风、功放音量和接线；有新模块时换掉 M2。
- 对调后重测外部声源（`实验记录/20261110_154011_p0test`，`--ref-target 80 200`）：
  - 无削波、无同步干扰；200 Hz 两麦相干 1.00。单音 ref 32 mV、err 153 mV；err 200 Hz 本底 4.1 mV → 可测降噪上限约 31 dB。
  - err 相对 ref +10.6 样本（模 40），与几何 428 mm ≈ 10.0 样本一致：参考麦领先误差麦约 1.3 ms。宽带 ANC 时这点余量远小于固件 16–32 ms 的块延迟，必须改小块；200 Hz 单音不受影响。
  - err 低频（<80 Hz）只有 2.5–7.9 mV（对调前 167–456 mV），误差麦低频问题已解决。脚本对此报 WARN 是相对比较的误报，绝对值比单音低 26 dB。
  - ref（M2）低频：静音 25 / 支架 52 / 贴管 262 mV（6–16 Hz）。M2 对振动很敏感，实验时不能碰管；参考通道必须加高通。调音量时 LEVEL 显示的 ref 78–198 mV 主要是这部分低频，单音本身只有 32 mV。
  - 3 次谐波 ref −27 / err −23 dB，两麦都没削波 → 手机喇叭失真。只针对 200 Hz 的 ANC 不受影响，但验收时要按 200 Hz 线谱算，不按总声级。
  - 结论：P0 完成，外部声源可用。手机保持这次的位置和音量。
- P1 完成：固件 0.2 的 `CAP n D` 同步采 DAC 输出（与 ADC 逐帧对齐，最多 10666 帧），上位机 `capture --dac`。
  - 对齐验证（`实验记录/20261110_162327_sid`，NOISE 0.01）：DAC→err 到达 5–6 样本、DAC→ref 8 样本，与 238/366 mm 声程一致，相差 3 样本。
  - NOISE 0.03 连采 3 次（`..._sid_a/b/c`）：误差麦 100–400 Hz 比静音高约 19 dB；DAC→err 相干 100–300 Hz 为 0.88–0.99，200 Hz 为 0.96–0.98。三次冲激响应（xcorr 粗估 256 抽头）互差 −17～−20 dB；Ŝ(200 Hz) 幅度 19.5–24.7 mV/码、相位 −19～−26°。
  - 325–400 Hz 是 Ŝ 的凹陷：350 Hz 处 |Ŝ| 约 1.1 mV/码，比 200 Hz 低约 27 dB，激励加大也没用（喇叭推不动误差麦位置），这个频段无法控制。
  - DAC→ref 相干只有 0.4（200 Hz 为 0.5），而参考麦带内比静音高约 19 dB → 参考麦（M2）在喇叭工作时收到大量与激励不相干的成分，同时 80 Hz 以下涨到 140–180 mV。推测是喇叭带动管壁振动，M2 对振动敏感且响应非线性。会影响 ANC 时参考信号的质量，待处理（M2 用软垫减振安装，或者换新模块）。
- 回流（`实验记录/20261110_173557_fb200`）：手机停，喇叭单独放到误差麦 153 mV 时，参考麦 200 Hz 为 10.8 mV。相对手机放声时的参考麦 32 mV，圈的放大倍数 0.34。两档严格成比例。参考麦比误差麦晚 1.8 个样本，是声音往上游走。最坏同相叠加 \(1/(1-0.34)\approx 1.5\) 倍。
- P4 先限制在 200 Hz 附近。227–234 Hz 的管共振是担心，不是回流已经测到的事实；上板后看误差麦频谱会不会在 230 Hz 附近冒尖。
- P2 完成（`实验记录/20261110_175018_p2shat`）：17:00 的三段 NOISE 0.03 做 384 阶最小二乘。Ŝ(200 Hz) = 25.5 mV/码、−21°。留一段验证，100–400 Hz NMSE 约 −18 dB；三段冲激响应互差约 −31 dB。用这只 Ŝ 预测随后的 200 Hz 单音：153 mV 实测，157 mV 预测，相位差 0.2°。|Ŝ| 在 133 Hz 和 232 Hz 各高约 3 dB，350 Hz 低 35 dB。控制抽头可以短，Ŝ 本身要留这 384 阶，尾巴是管子在响。
- 辨识回归没有做 80 Hz 高通，只对 DAC 码和误差麦各自减了直流。带内 NMSE 用的 100–400 Hz 带通是事后打分，零相位，没有写进系数。DAC→误差麦相干，100–400 Hz 平均 0.84，180–220 Hz 平均 0.97–0.98，200 Hz 为 0.975–0.986。合格线改为 200 Hz 附近 >0.9。
- 上板前 Ŝ 要和 P4 的因果高通对齐：8 kHz 采样、截止 80 Hz 的 Butterworth，200 Hz 处一阶相位 +21.8°（幅度 −0.6 dB），二阶 +33.9°（幅度 −0.1 dB）。用 `filtfilt` 对齐会把相位消掉，不算数。
- P3 离线仿真（`实验记录/20261110_195059_p3sim`），没上板、没改固件。20 s 的 x、d 是按 `4_stand` 的 200/600 Hz 和残差谱合成的，没有把短录音首尾接起来。合成的 200 Hz 和录音对得上：ref 32.0/32.1 mV，err 152.7/149.8 mV，延迟 10.64/10.67 样本。
- 推荐这一组：N=16，μ=0.005，γ=0，二阶 80 Hz 因果高通并卷进 Ŝ，DAC 限在 −2048…2047。4 s 正弦拟合 −47.6 dB，0.25 s 窗中位数 −31.4 dB，收敛 0.38 s。y rms 7.3 码，没有碰到限幅。合格线达到。逐项对比固定在 μ=0.01，二阶对齐再加量化已经是 −47.6/−32.9 dB、0.76 s，不是把 μ 调到边界才过的。
- μ 扫描里稳定的只有 0.005 和 0.01。0.015 起，末尾 4 s 输出一直顶在 DAC 上。上界在 0.01 和 0.015 之间，没有更密的点。N=4 发散。N=8 是 −28.8/−27.5 dB、0.30 s。N=32 的短时窗和 N=16 一样，都是 −32.9 dB。
- 量化对 200 Hz 线几乎没有影响（二阶对齐 −47.9，量化后 −47.6）。
- 不加高通、N=16、μ=0.01 时仿真发散。这不能当成管子一定会叫：F 只在 200 Hz 测过（1.73 mV/码，晚 4.15 样本），仿真把同一个增益用到了全频带，而 |S| 在 10 Hz 只有 0.078 mV/码。二阶高通即使没卷进 Ŝ 也能把这档稳住。一阶高通必须卷进 Ŝ，否则同一档 μ 发散。
- 给 Ŝ 加相位（只在 200 Hz 准确）：+75° 仍有 −39 dB，+90° 只剩 −16 dB，−90° 发散。
- 贴管 6–16 Hz：Welch 算参考麦 244 mV。上面写的 262 mV 是窄带 IIR，会把 200 Hz 漏进这个带。冲击只加在参考麦上。归一化步长没有被压短（1/(‖x'‖²+ε) 约 8.7×10⁻⁸，和无冲击一样）。二阶高通下 200 Hz 仍是 −47/−31 dB。没有高通时 y rms 升到 32 码，单音还在降。不确定真实碰管子时误差麦吃进多少，这段录音里误差麦 6–16 Hz 只有 0.8 mV。
- 副作用（Welch）：133 Hz +6.2 dB，230 Hz +7.1 dB，400 Hz 不变。100–400 Hz 总能量 −9.8 dB。230 Hz 抬高了，绝对高度仍低于关环时的 200 Hz 线。F 在 230 Hz 没有测过，所以上板后还要再看。
- 保护是仿真里定的，不是测到的：误差麦 50 ms rms 连续 4 窗高于开环 rms 的 2 倍，就清零 W 并静音。推荐参数开着保护不会误触发。相位反过来或 μ×10，0.20 s 切断。
- P4 固件 0.3（`实验记录/20261110_205912_p4prep`）：逐样本 FxNLMS，Ŝ 用 `shat.npz` 的 `h_err`，高通在上位机卷进 384 阶后下发。开机 μ=0.002、γ=0、限幅 ±40。`pytest` 19 项通过。第一版经 ST-Link 校验烧入并复位。随后只加了「ANC 开着时 `XCHK` 直接拒绝」，重烧时已经没有 ST-Link，芯片里仍是第一版。
- 第 2 步（固件回传的 x' 对上位机）和第 3 步（`CLAMP 0`、三次 `CAP` 时的 `slip`/`cpu`）没有做。COM16、COM8、COM14 打开都是信号灯超时，SPP 没连上，版本字符串没读到。没有发单音、噪声或扫频。
- 闭环时的顺序：手机的 200 Hz 先响几秒，再 `ANC ON`。基线是 ANC 关着时估的，门槛是它的 2 倍；基线写在状态行的 `baseline=` 里。没有用「基线太小」去锁住 `ANC ON`，因为静音 CPU 测试也要开着 ANC。
- 晚一拍不一定进 `late`/`udr`：DAC 重复旧码不算欠载。固件另有 `slip`，门槛是中断后超过两个采样周期（250 µs）才写上。声学上的 5–6 个样本要等喇叭可以响之后用 `CAP` 多测几次，`lag_us` 不能代替。
- 第 2、3 步（`实验记录/20261110_210931_p4prep`）：COM16 通。400 点 x' 和上位机 float32 逐点相同，最大误差 0，CRC 143A81AB。`CLAMP 0` 下三次带 DAC 的 CAP，码全部是 2048。CPU 34%–36%，`lag_us` 10–12，`slip`/`late`/`ovr`/`udr`/`rxovf` 都是 0。三次写槽时间一样，没有一拍、两拍来回跳。
- 第一次对账作废（`实验记录/20261110_210253_p4prep`）。命令以 `\r\n` 结尾时，固件读到 `\r` 就返回，`\n` 留在缓冲里，被 `XCHK` 当成数据，400 个码错开 1 字节。上位机对 `XCHK` 改成只发 `\n` 之后，误差变成 0。源码里 getline 会把配对的 `\r\n` 吃掉，ST-Link 不在，这版还没烧进芯片。
- 保护在第一次 CAP 回传后锁上。当时基线 162 mV，门槛 324 mV。锁上时固件报的 50 ms 窗是 493 mV，200 Hz 仍是 15 mV；存下的 0.25 s 里误差麦只有约 80 mV。493 mV 发生在串口送数的那一秒，缓冲里没有这段波形。不确定是蓝牙耦进去还是管子上有冲击。阈值没改。测完已关 ANC，限幅设回 ±40。结束时基线约 25 mV。
- 声学上的 5–6 个样本这次仍没测。闭环前先让手机的 200 Hz 响几秒，再 `ANC ON`。
- 换行修复已烧入并复测（`实验记录/20261110_211546_p4prep`）。`XCHK` 改回 `\r\n`，400 点最大误差仍是 0，`rxovf` 是 0。CPU 34%–36%，写槽三次都是 12 µs，`slip`/`late`/`ovr`/`udr` 都是 0，DAC 全是 2048。基线 25.5 mV，回传期间保护没有锁，上一轮的 493 mV 没有复现。测完 ANC 关，限幅回到 ±40。
- DAC→误差麦到达（`实验记录/20261110_212446_p4delay`）：ANC 保持关，`NOISE 0.03`，三段各 10666 帧。到达都是 5 个样本，和 Ŝ 的上升沿一致（第 4 点仍远小于峰值，第 5 点跨过 30%）。DAC rms 35–36 码，和 P2 相同。测量期间 cpu 约 34%，slip/late/ovr/udr 都是 0。测完已 STOP。200 Hz 相干 0.76/0.90/0.84，低于 P2 的 0.96–0.98。开噪声前基线已经是 155 mV，静下来之后仍是 156 mV。没有开 ANC。
- 10 s 闭环没有做（`实验记录/20261110_213549_p4try`）。手机已放 200 Hz。ANC 关着时误差麦 192 mV、参考麦 44 mV，基线 206 mV。相对 P0 的 153 mV、32 mV 高出 26% 和 37%，超过 20%。没有开 ANC。
- 放宽预检后再读（`实验记录/20261110_214041_p4try`）：误差麦 6.0 mV，参考麦 2.2 mV，比值 2.70，基线 80 mV，门槛 160 mV。两路都不在 100–260 / 25–60，比值也不在 3.8–5.8。没有开 ANC。
- 手机开声后的 10 s 试跑（`实验记录/20261110_214141_p4try`）在 0.55 s 停下。开环误差麦 196 mV、参考麦 43 mV、比值 4.55、基线 218 mV、门槛 437 mV。μ=0.005，γ=0，限幅 ±40。0.55 s 时误差麦 200 Hz 到 32 mV，同时限幅计数到 73，立刻关掉。没有跑满，32 mV 不算稳态。prot=0，slip/late/ovr/udr=0。没有重试。
- μ=0.002 的 3 s 没有做（`实验记录/20261110_214925_p4run3`）。误差麦 73 mV、参考麦 26 mV、比值 2.82、基线 367 mV。误差麦低于 100 mV，比值低于 3.8。没有开 ANC。固件加了 `CARM`/`CGET`，采集可以在后台进行；这次没用上。
- 放开预检和限幅停止，μ=0.005 开了 8 s（`实验记录/20261110_215257_p4demo`）。开前误差麦 271 mV。末 2 s 的 0.25 s 窗在 33–124 mV 之间，中位数 84 mV，约 10 dB。约 0.3 s 就低于开环 3 dB，之后没有稳住。限幅 8 s 里碰到 6084 次，全程都有，不是只有开头。prot=0，slip/late/ovr/udr=0，CPU 约 35%。关掉后误差麦回到 289 mV。
