COSMOS-LYX/DuctANC/01_设计评估.md

# 总体设计架构评估

评估对象：`00_原始资料/总体设计架构.md`（2026-11-08 版）。
结论先行：**架构方向正确，可以作为毕设的基础**。前馈 + FxNLMS + 白噪声离线辨识次级路径、采样中断不进 RTOS，这些是管道 ANC 的标准做法，数字和引脚基本自洽。主要风险不在算法，而在**声学与测量**：参考/误差麦的相干性、声反馈、风扇机壳的旁路辐射、抗混叠不足。另外原文档是「课程设计」深度，作为毕设需要再加一两块有研究含量的内容。

---

## 1. 核对过、成立的部分

| 项目 | 核对结果 |
| --- | --- |
| 平面波假设 | 内半径 35 mm，\(f_c = 1.841c/(2\pi a) \approx 2.87\) kHz（按 35.5 mm 约 2.83 kHz）。100–400 Hz 远低于截止，一维模型成立 |
| 因果余量 | 参考麦→三通轴线 278 mm（0.81 ms）；纸盆→轴线 88 mm（0.26 ms）+ 电延迟 0.20 ms = 0.46 ms。余量 0.35 ms，与原文 354 μs 一致 |
| 算力 | 每拍约 96（W 滤波）+ 160（Ŝ 滤波）+ 96（更新）≈ 350 次乘加，×8 kHz ≈ 2.8 M MAC/s，F407 168 MHz 带 FPU 占用不到 5% |
| 引脚 | PC0/PC1 = ADC123_IN10/11，PA4 = DAC_OUT1，ADC1 用 DMA2 Stream0，TIM2_TRGO 可触发 ADC1，USART1 = PA9/PA10，I2C2 = PB10/PB11，均与 F407 手册一致 |
| Flash | VET6 512 KB，扇区 7 起于 0x08060000（128 KB），程序限前 384 KB，正确 |
| RTOS 划分 | DMA 中断优先级 1 高于 `configMAX_SYSCALL_INTERRUPT_PRIORITY` 且不调内核 API，这是对的；滤波器不放任务里，避免调度抖动 |
| 辨识方法 | 风扇关、注入白噪声、回归量用注入的电信号，避免了声反馈污染 Ŝ，正确 |
| 麦克风 | 强调固定增益、禁止 AGC，正确（AGC 会使次级路径时变导致发散） |
| 风扇噪声频段 | 8025 风扇约 2000–3000 rpm、7 叶，叶片通过频率约 230–350 Hz，正好落在 100–400 Hz 内；线谱成分容易降 |

---

## 2. 风险与问题（按严重程度）

### R1 参考—误差相干性决定降噪上限（高）

前馈 ANC 的理论上限由参考麦与误差麦（主噪声部分）的相干函数 \(\gamma^2\) 决定：

\[
NR_{max} = -10\lg(1-\gamma^2)
\]

| \(\gamma^2\) | 0.90 | 0.95 | 0.99 |
| --- | --- | --- | --- |
| 上限 | 10 dB | 13 dB | 20 dB |

要达到 10 dB，频段内 \(\gamma^2\) 必须 ≥ 0.9。参考麦离风扇只有 150 mm，并且**齐平安装在有气流的管壁上**，湍流压力脉动（局部、不传播、两麦之间不相干）会直接拉低相干性。仿真里没有这一项，所以 21 dB 不可直接期待。

建议：
- 把「风扇开、ANC 关，同时录两路麦，算 100–400 Hz 相干函数」作为**第一个实验**，在写任何算法之前做。
- 麦克风加防风海绵，或做成侧壁小腔 / 打孔管段后面的凹装，避开主流。
- 参考麦往下游挪（比如离风扇 250–300 mm），远离叶片近场。

### R2 声反馈没有补偿（高）

原文承认 \(x = x_0 + f*y\)，但只靠把 μ 降到 0.10 硬扛（仿真 21.2 → 15.1 dB）。实物上反馈路径受管端反射影响，可能比名义值更强，容易啸叫，而「不啸叫」是指标之一。

建议：加**声反馈中和（FBN）**。辨识阶段本来就在注入白噪声，同时把参考麦信号对注入信号做一次 NLMS，就得到 \(\hat F\)；运行时用 \(x_0 \approx x - \hat F * y\) 作为参考。几乎零额外硬件成本，代码量小，效果明显，也是论文里很好写的一节（Kuo & Morgan 的标准结构）。

### R3 风扇机壳旁路辐射与测量方法（高）

风扇在管外，它的机壳和进风面会**直接向房间辐射**噪声，不经过管道，ANC 管不到。如果在出风口外用麦克风/声级计测，旁路声会封顶测得的降噪量，看起来就「降不下来」。另外如果拿误差麦本身来评价降噪，它是被最小化的那个量，数会偏好看，答辩时容易被质疑。

建议：
- 风扇装进一个密封、内贴吸音棉的小箱子，只留进风口（或进风口接一段消声管）。
- 增加**第三只监测麦**放在出口外（如轴线 0.3 m 处），只用来评价，不参与控制。前后两次测量位置固定、同一增益。
- 背景噪声先测一遍，目标频段至少比背景高 15 dB，否则 10 dB 降噪测不出来。

### R4 抗混叠与重建滤波太弱（中）

一阶 RC 2.2 kΩ/22 nF 截止约 3.3 kHz。采样 8 kHz 时，7.6–7.9 kHz 的成分会折叠到 100–400 Hz，而 RC 在 7.8 kHz 只衰减约 7.6 dB。风扇和电机电磁噪声在几 kHz 往往不弱。DAC 侧同理，8 kHz 零阶保持的镜像会被 3 寸喇叭放出来。

建议（任选其一）：
- **ADC 过采样**：TIM2 触发 32 kHz 或 64 kHz，ISR 里做 4/8 点平均或简单 CIC 抽取到 8 kHz，再加一级数字低通。只多几十 μs 群时延，模拟部分不用改。
- 或改为二阶 Sallen-Key（截止 ~1.5 kHz）。注意每多一阶都吃掉因果余量。
- **不要换成 Σ-Δ 音频 Codec**（如 WM8731 类）：它们的数字滤波器群时延通常几百 μs 到 1 ms 以上，会直接把 354 μs 余量吃光。

### R5 因果余量偏紧（中）

354 μs 只有约 2.8 个采样，且 200 μs 的电延迟是预算值。逐项估计：ADC 采样 + 计算 + DAC 写入约 30 μs，DAC 零阶保持 62.5 μs，抗混叠 RC 约 48 μs，重建 RC 约 33 μs，合计约 175 μs，再加 R4 的过采样滤波就会接近或超过 200 μs。对风扇线谱（可预测）影响不大，但对宽带部分会降低效果。

建议：上游管从 380 mm 加长到 600 mm 左右（便宜），参考麦→注入点拉到约 0.5 m，余量增加到约 1 ms。上板后用「扬声器发脉冲、看误差麦响应起点」实测电+声延迟，写进论文。

### R6 管道驻波与误差麦位置（中）

- 管两端都是强反射（低频时开口端 \(ka \approx 0.065\)，几乎全反射），全长约 0.7 m，半波共振约 240 Hz、480 Hz，**在目标频段内**。一次/次级路径会出现尖峰，脉冲响应拖尾长。W 96 阶 = 12 ms，在 100 Hz 不到一个周期，可能不够，建议仿真和实物都试 128–256 阶（算力足够）。
- 误差麦离出口 118 mm（加端部修正约 140 mm）。开口端是声压节点，100 Hz 时误差麦处声压只有驻波最大值的约 25%（−12 dB），信噪比偏低。可以接受，但如果误差信号太小，考虑把误差麦再往上游挪一点，或在实验中验证。

### R7 功放增益匹配（中）

PAM8403 固定约 24 dB 增益，5 V BTL 输出在输入约 0.3 V 峰值就会削波，而 DAC 中点偏置后摆幅 ±1.65 V。现在靠软件 `G 0.5`、`C 0.9` 压，等于浪费了 DAC 分辨率并且削波风险大。

建议：PA4 与 PAM8403 之间加电阻分压（约 1/5～1/8），让 DAC 满幅对应功放接近满功率。另外 PAM8403 是 BTL 输出，喇叭负端不能接地；它是 D 类、开关频率数百 kHz，PCB 上要和麦克风模拟地分开走线。

### R8 扬声器后腔（低）

3 寸喇叭装在 dn75 管帽小后腔里，谐振频率会被推高，100 Hz 附近输出会掉。管内平面波辐射效率高，可能够用，但要在辨识出的 Ŝ 频响里确认 100 Hz 处的幅度，必要时加长后腔。

---

## 3. 作为毕业设计的深度建议

原文档对应的是课程设计指标。毕设一般要求有对比、有分析、有改进。建议在现有基础上选 2–3 项作为「创新点 / 工作量」：

| 方向 | 工作量 | 价值 |
| --- | --- | --- |
| 声反馈中和 FBN-FxNLMS（R2） | 小 | 直接解决啸叫，有对比实验 |
| 在线次级路径建模（Eriksson 辅助噪声法或其改进） | 中 | 温度、气流、喇叭老化时不用重新辨识，论文素材多 |
| 算法对比：LMS / FxLMS / FxNLMS / FBN-FxNLMS，必要时加 IIR 结构（FuLMS） | 中 | 仿真 + 实测双重对比，章节结构清晰 |
| 相干性分析与麦克风安装方式对比（R1） | 小 | 解释「为什么降了这么多 / 没降下来」，答辩说服力强 |
| 自画控制板（含 MAX4466 等效前级、二阶抗混叠、功放分压、模拟/数字地分割） | 中 | 原文档里还没做，是硬件工作量的主体 |
| 混合 ANC（前馈 + 反馈） | 大 | 对宽带、相干性差的部分有改善，难度明显上升 |

## 4. 建议的推进顺序

1. 搭管 + 风扇箱 + 两只麦，**先测频谱、背景噪声和相干函数**（决定是否需要改麦克风安装）。
2. 实测扬声器到误差麦的延迟与 Ŝ 频响，复核因果余量。
3. 按原架构跑通 FxNLMS，拿到第一个实测 dB。
4. 加 FBN、过采样，对比改进前后。
5. 做选定的加深项（在线辨识或算法对比），同时画 PCB。
6. 用第三只监测麦做最终测量，出论文曲线。
