COSMOS-LYX/DuctANC/03_参考资料.md

# 参考资料

PDF 放进 `资料/论文/` 或 `资料/数据手册/`，在这里登记。

## 书籍

| 资料 | 用途 |
| --- | --- |
| S. M. Kuo, D. R. Morgan, *Active Noise Control Systems: Algorithms and DSP Implementations*, Wiley, 1996 | FxLMS、声反馈中和、管道 ANC 实现，最贴近本课题 |
| S. J. Elliott, *Signal Processing for Active Control*, Academic Press, 2001 | 因果性、相干性上限、收敛分析 |
| P. A. Nelson, S. J. Elliott, *Active Control of Sound*, Academic Press, 1992 | 管道声学与主动控制物理基础 |
| B. Widrow, S. D. Stearns, *Adaptive Signal Processing*, Prentice-Hall, 1985 | LMS 理论 |
| C. H. Hansen, *Understanding Active Noise Cancellation*, Spon Press, 2001 | 入门、工程直觉 |

## 论文

| 资料 | 用途 |
| --- | --- |
| S. M. Kuo, D. R. Morgan, "Active noise control: a tutorial review," *Proc. IEEE*, 87(6), 1999 | 综述，开题报告必引 |
| L. J. Eriksson, M. C. Allie, "Use of random noise for on-line transducer modeling in an adaptive active attenuation system," *JASA*, 85(2), 1989 | 在线次级路径建模 |
| L. J. Eriksson, "Development of the filtered-U algorithm for active noise control," *JASA*, 89(1), 1991 | IIR 结构 / 声反馈 |
| M. Zhang, H. Lan, W. Ser, "Cross-updated active noise control system with online secondary path modeling," *IEEE Trans. Speech Audio Process.*, 9(5), 2001 | 在线辨识改进 |

（作者、卷期以检索到的原文为准，下载后核对。）

## 器件手册（待下载到 `资料/数据手册/`）

- STM32F407xx Datasheet、RM0090 参考手册
- MAX4466 Datasheet
- PAM8403 Datasheet
- 所选 3 寸扬声器的 T/S 参数
- 8025 风扇规格（转速、叶片数）
