COSMOS-LYX/DuctANC/实验记录/20261109_170228_mictest/1_quiet.png

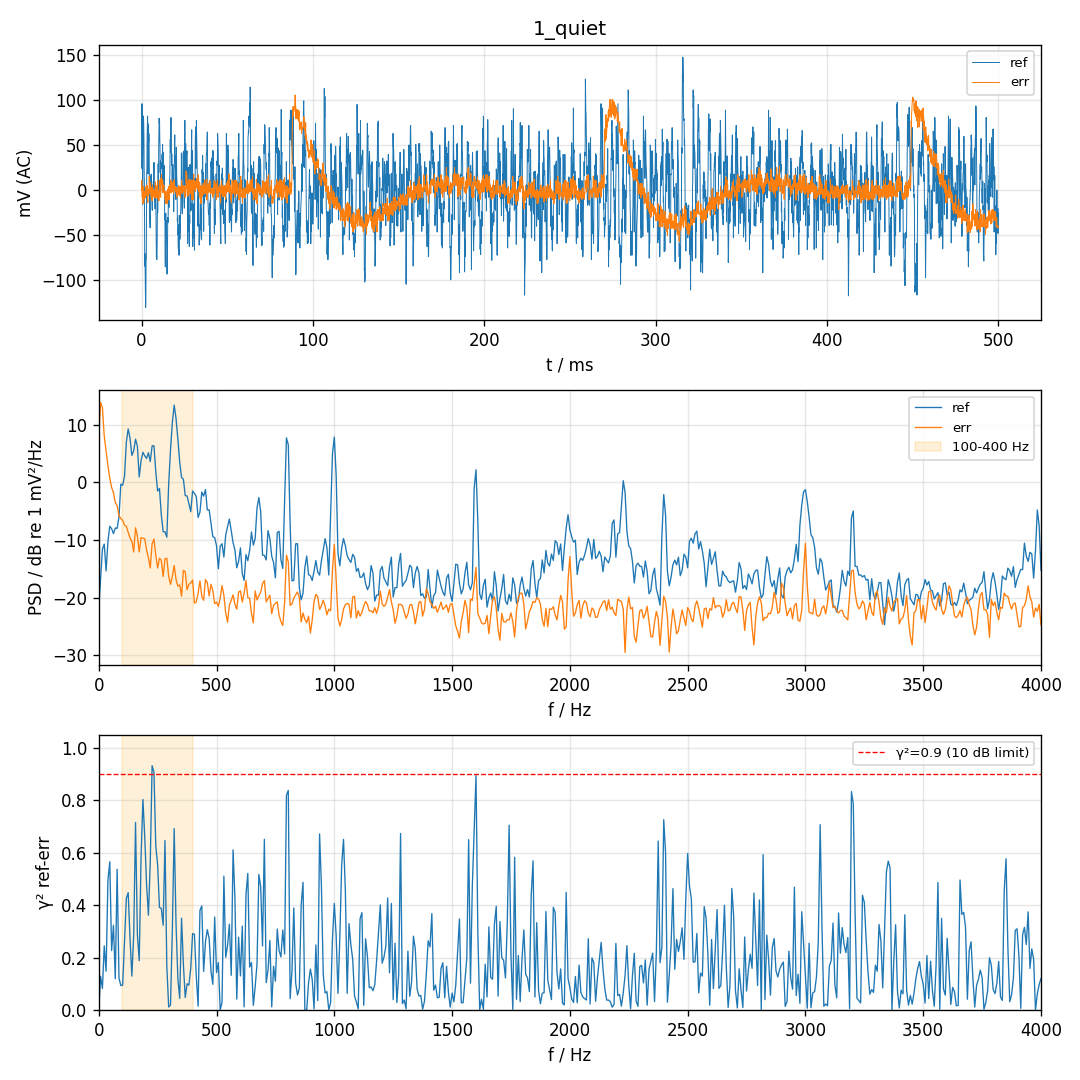
实验记录/20261109_170228_mictest/1_quiet.png
