COSMOS-LYX/DuctANC/实验记录/20261109_170228_mictest/2_speaker_noise.png

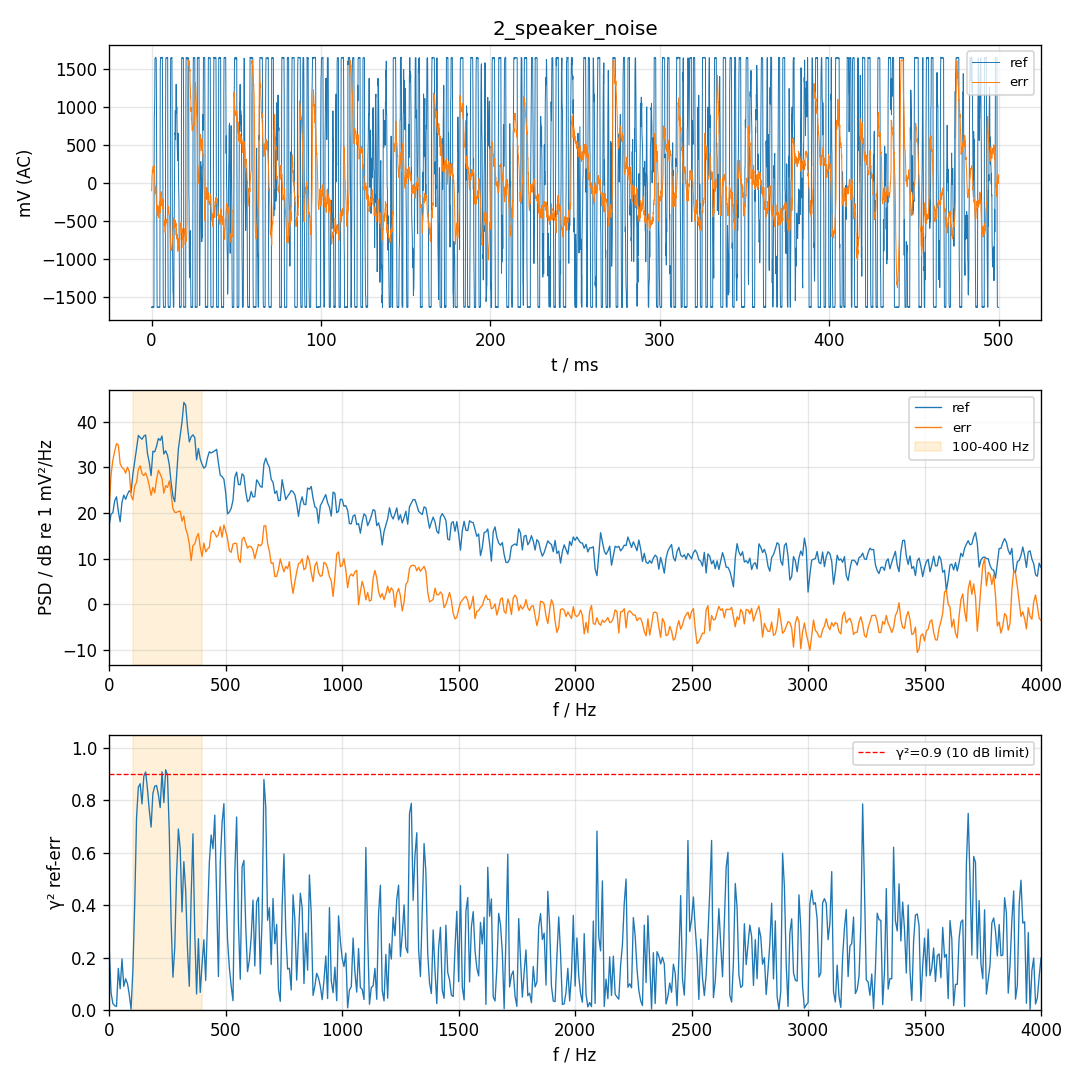
实验记录/20261109_170228_mictest/2_speaker_noise.png
