COSMOS-LYX/DuctANC/实验记录/20261109_170228_mictest/3_fan.png

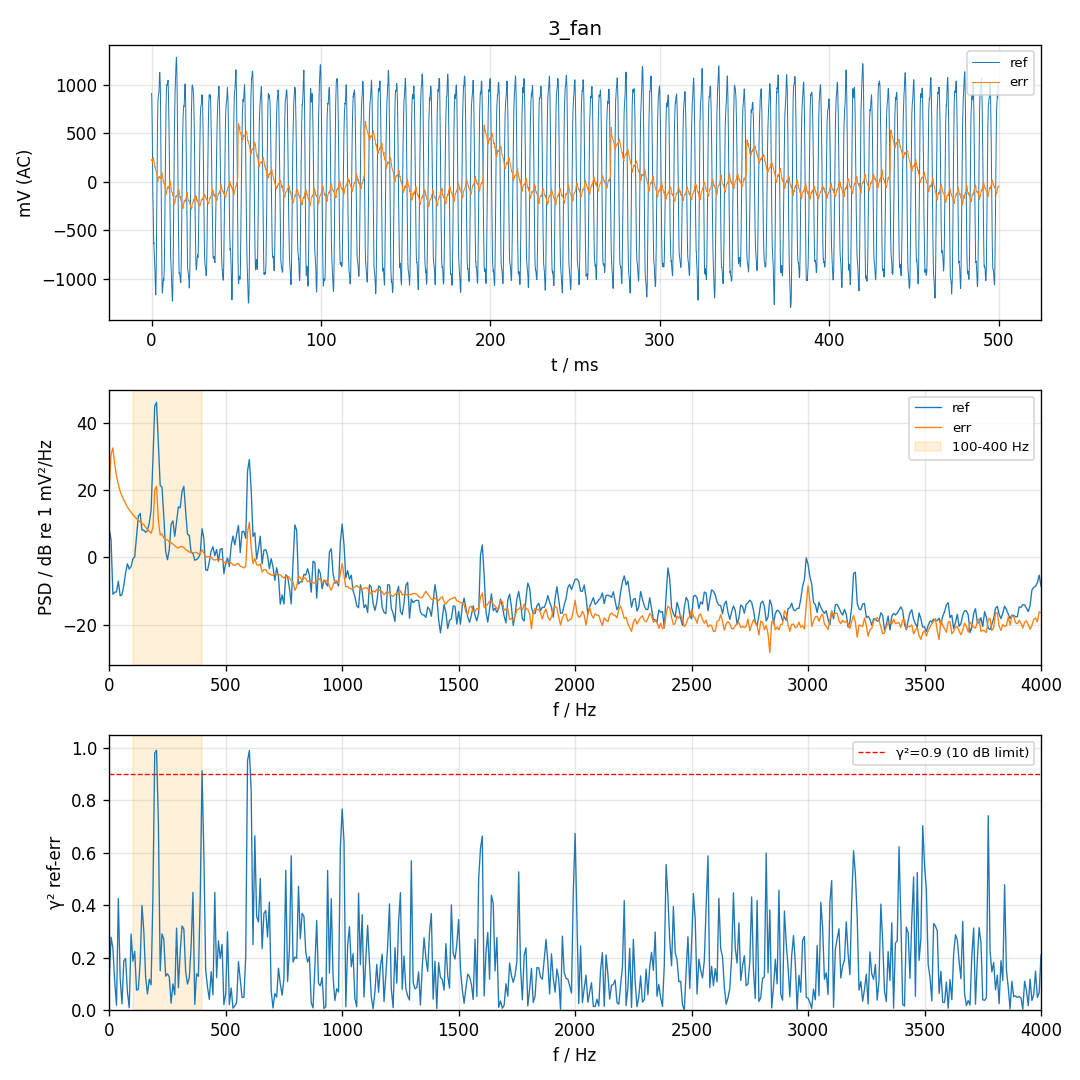
实验记录/20261109_170228_mictest/3_fan.png
