COSMOS-LYX/DuctANC/实验记录/20261110_160847_speedtest/speedtest.png

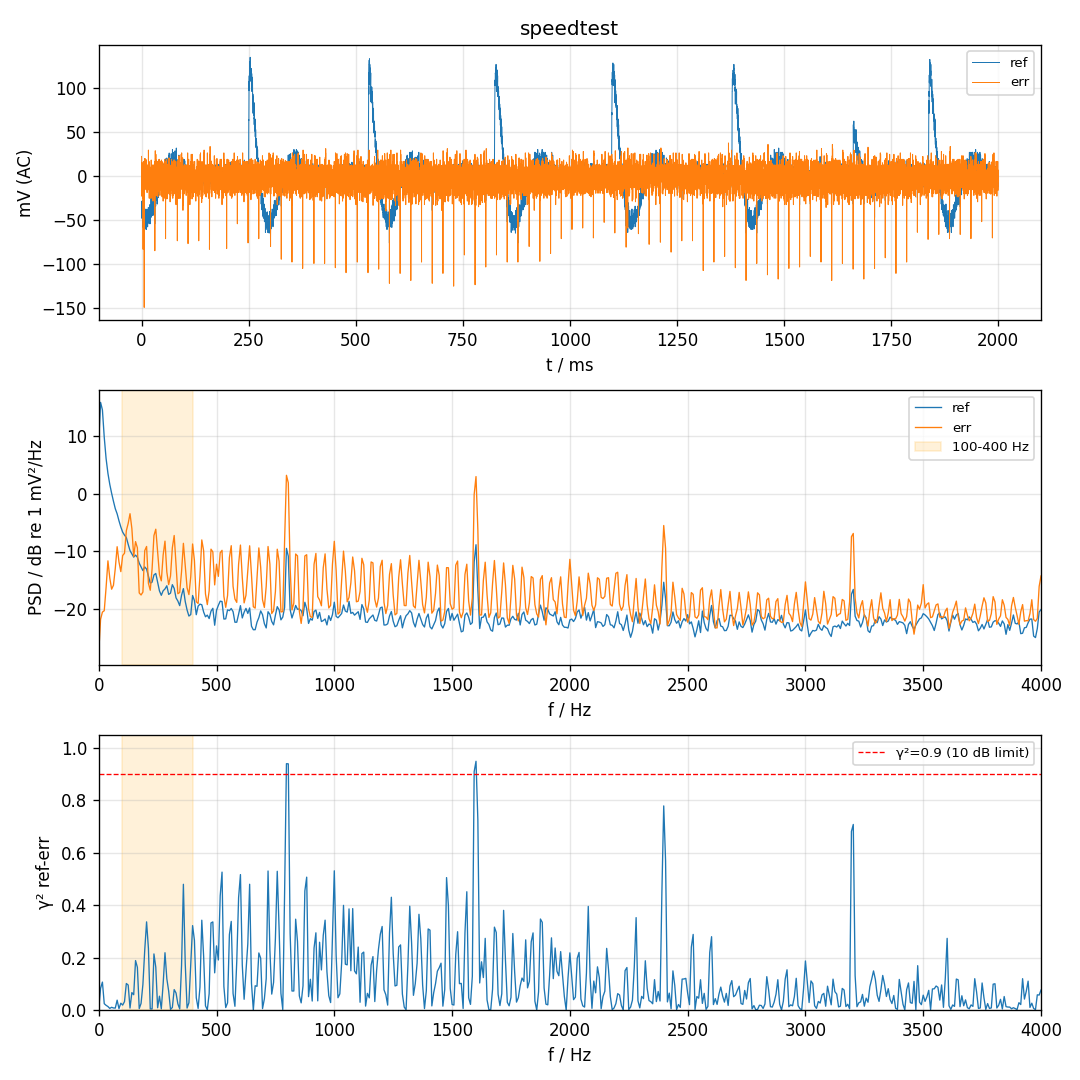
实验记录/20261110_160847_speedtest/speedtest.png
