COSMOS-LYX/DuctANC/实验记录/20261110_162837_sid_c/sid_c_dac.png

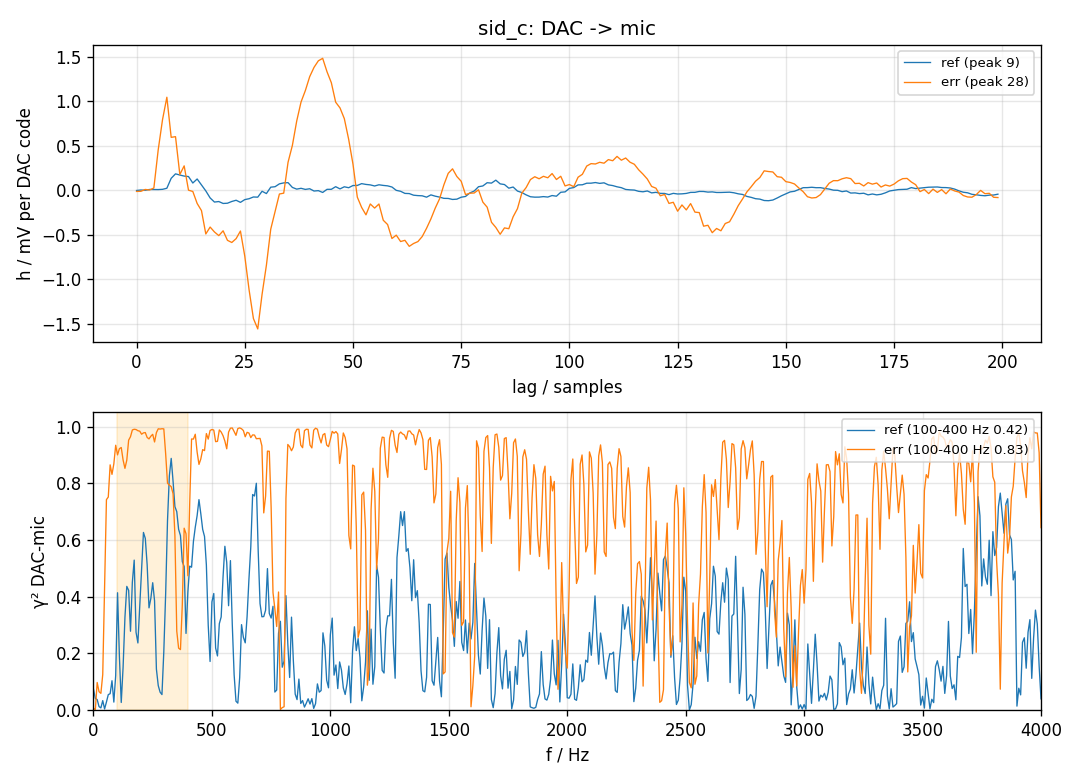
实验记录/20261110_162837_sid_c/sid_c_dac.png
