COSMOS-LYX/DuctANC/实验记录/20261110_164639_sid_c/sid_c.png

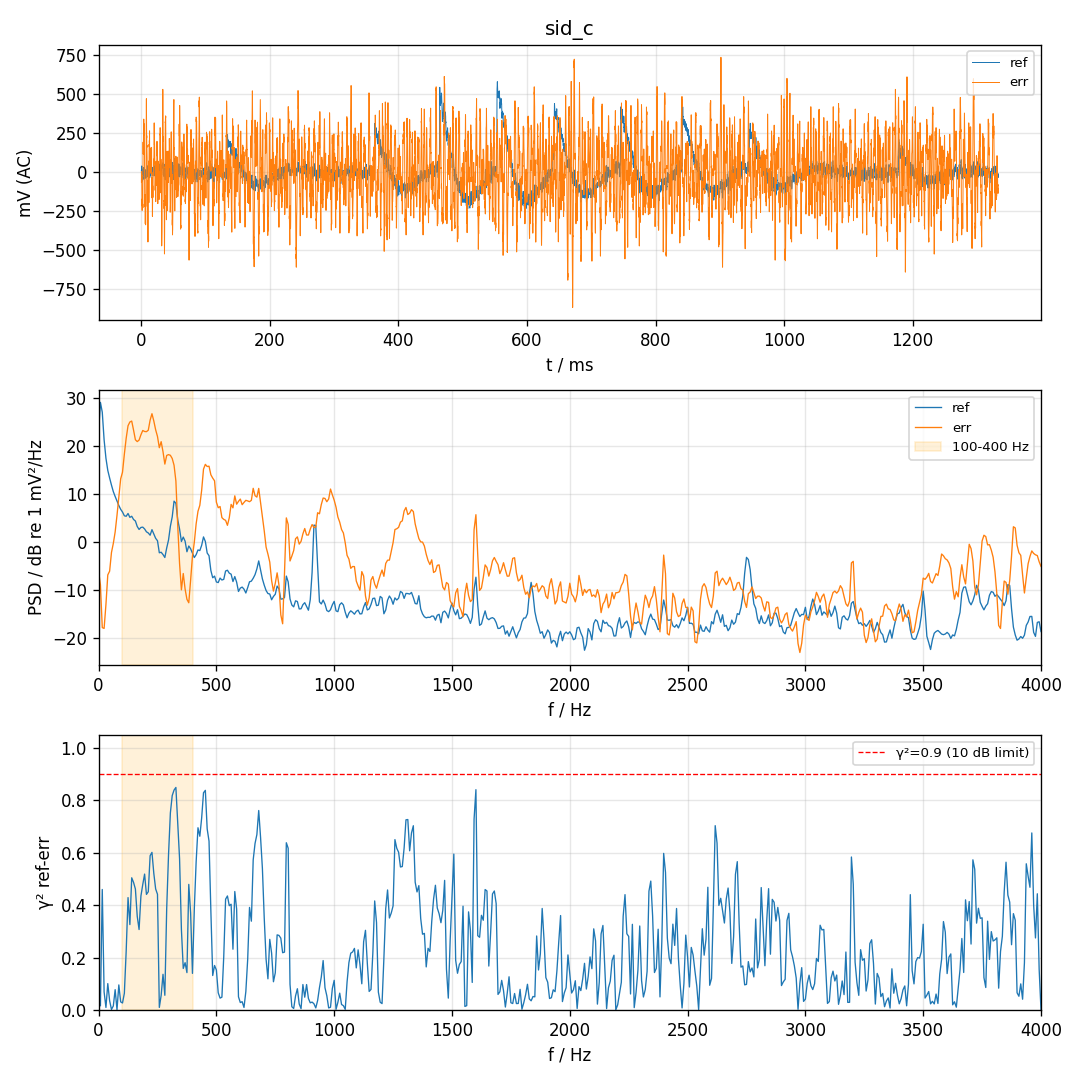
实验记录/20261110_164639_sid_c/sid_c.png
