COSMOS-LYX/DuctANC/实验记录/20261110_165057_sid_b/sid_b.png

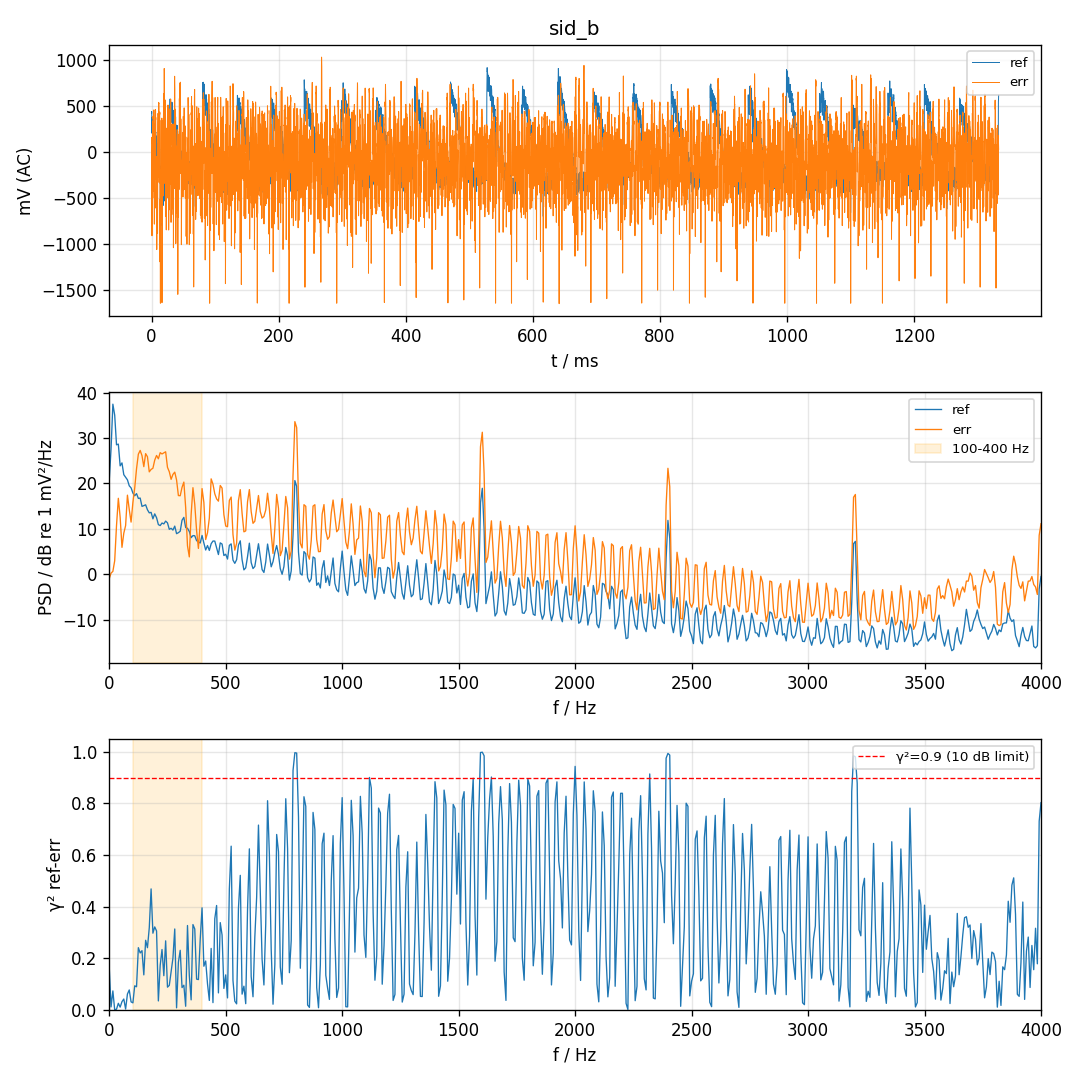
实验记录/20261110_165057_sid_b/sid_b.png
