COSMOS-LYX/DuctANC/实验记录/20261110_165145_sid_b/sid_b_dac.png

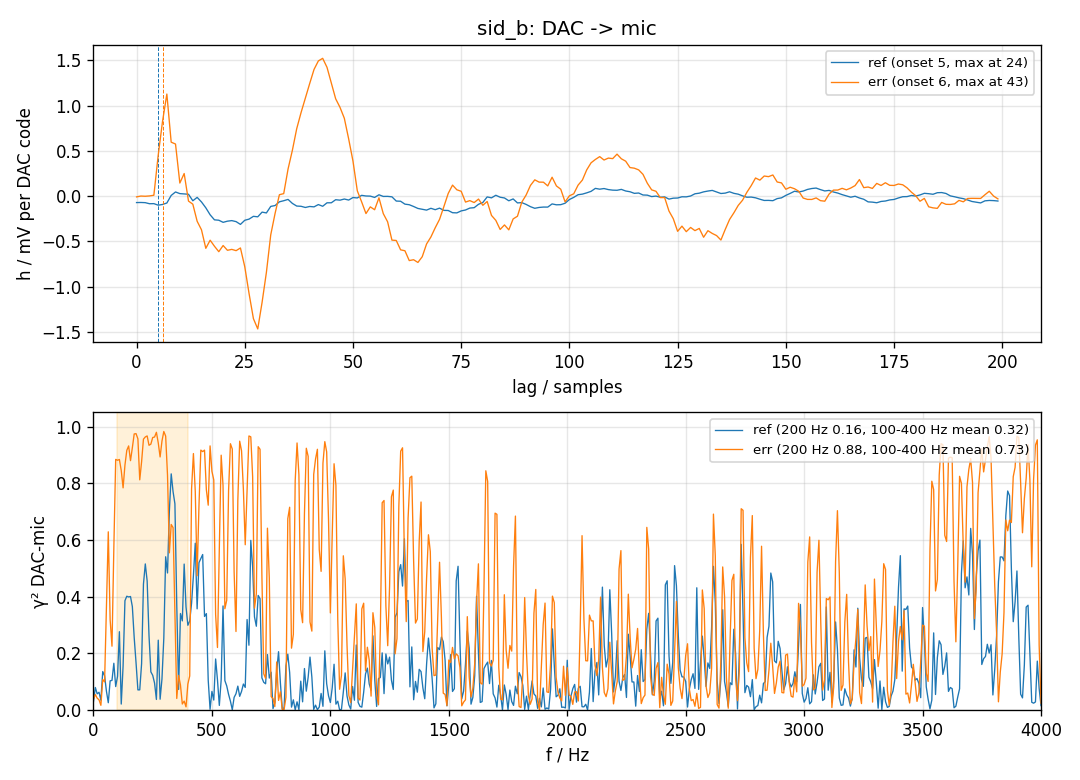
实验记录/20261110_165145_sid_b/sid_b_dac.png
