COSMOS-LYX/DuctANC/实验记录/20261110_165926_sid/sid.png

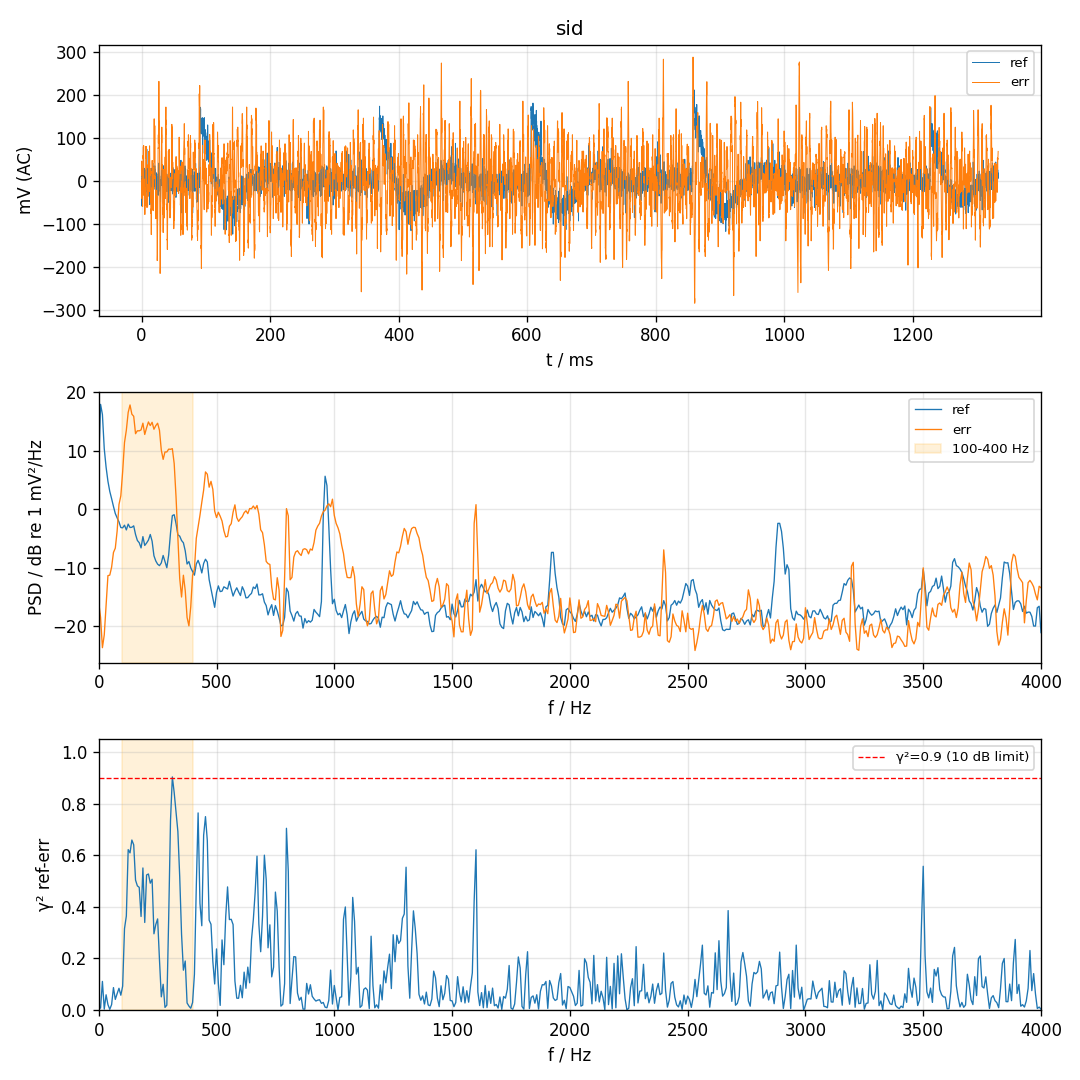
实验记录/20261110_165926_sid/sid.png
