COSMOS-LYX/DuctANC/实验记录/20261110_165959_sid_a/sid_a_dac.png

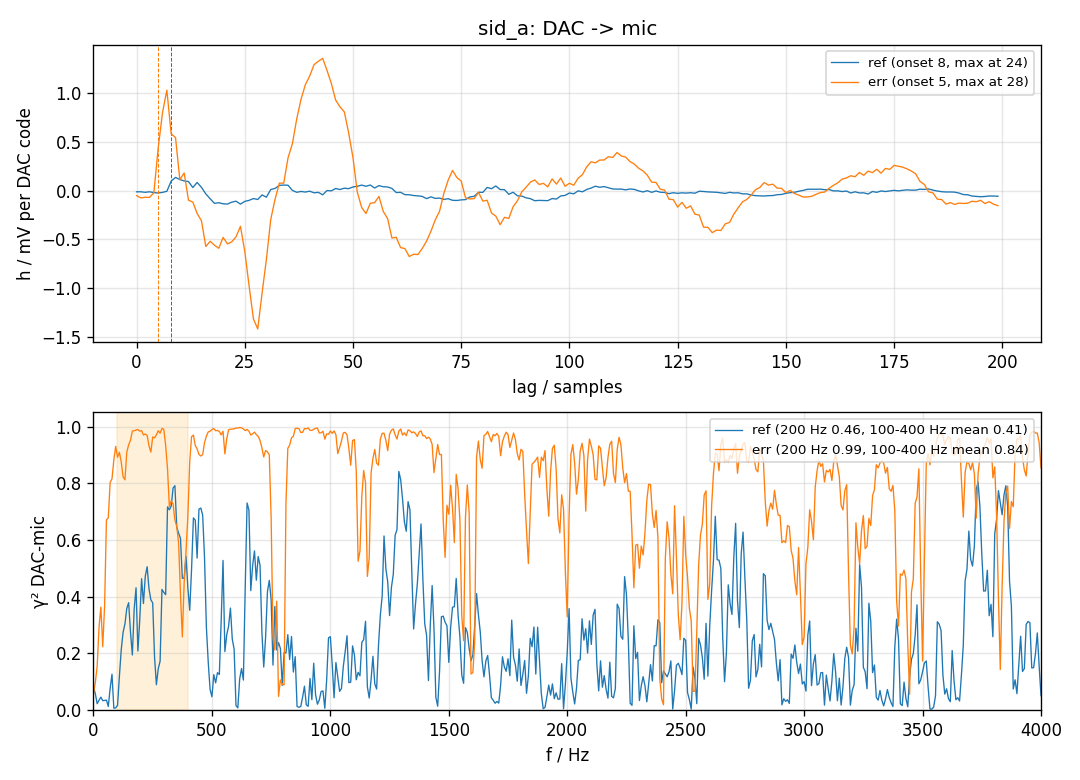
实验记录/20261110_165959_sid_a/sid_a_dac.png
