COSMOS-LYX/DuctANC/实验记录/20261110_173557_fb200/1_probe_dac.png

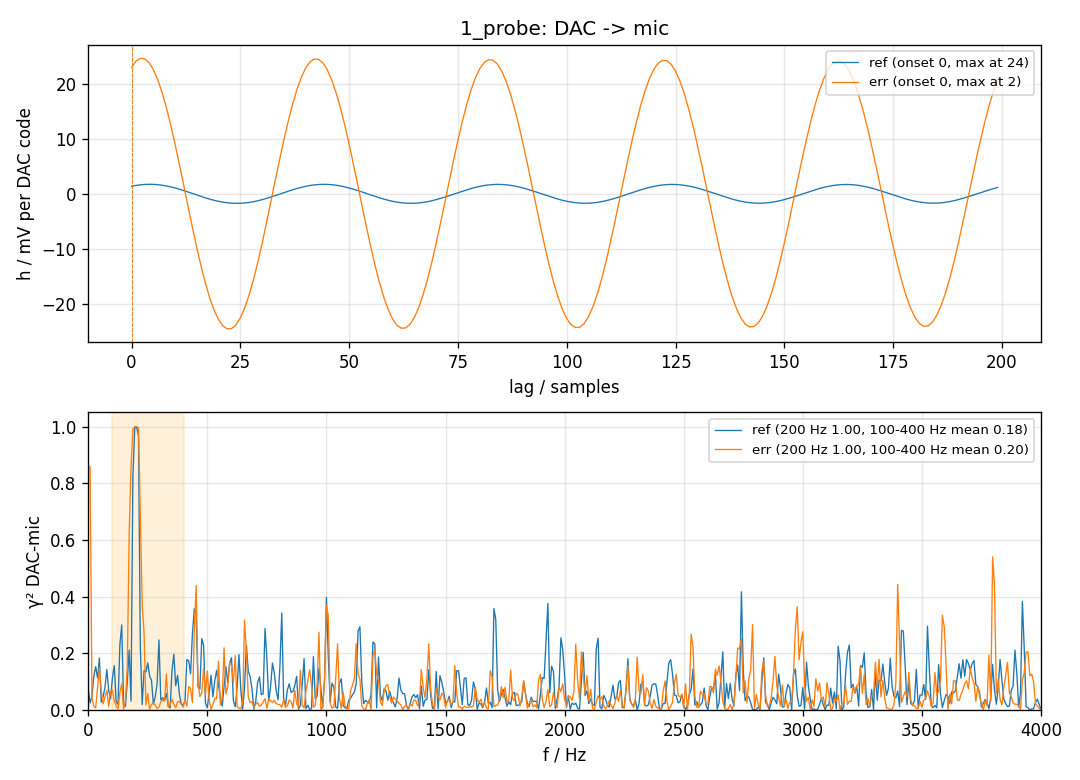
实验记录/20261110_173557_fb200/1_probe_dac.png
