COSMOS-LYX/DuctANC/实验记录/20261110_212253_p4delay/cap0_dac.png

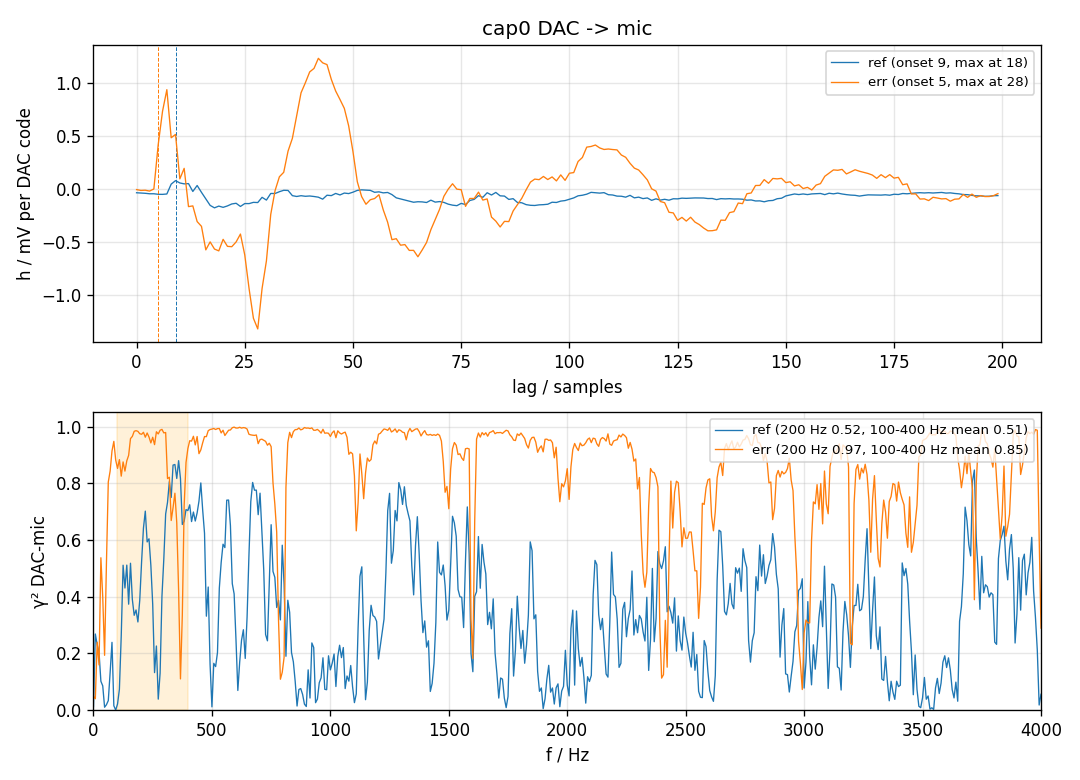
实验记录/20261110_212253_p4delay/cap0_dac.png
