COSMOS-LYX/DuctANC/实验记录/20261110_212446_p4delay/cap1_dac.png

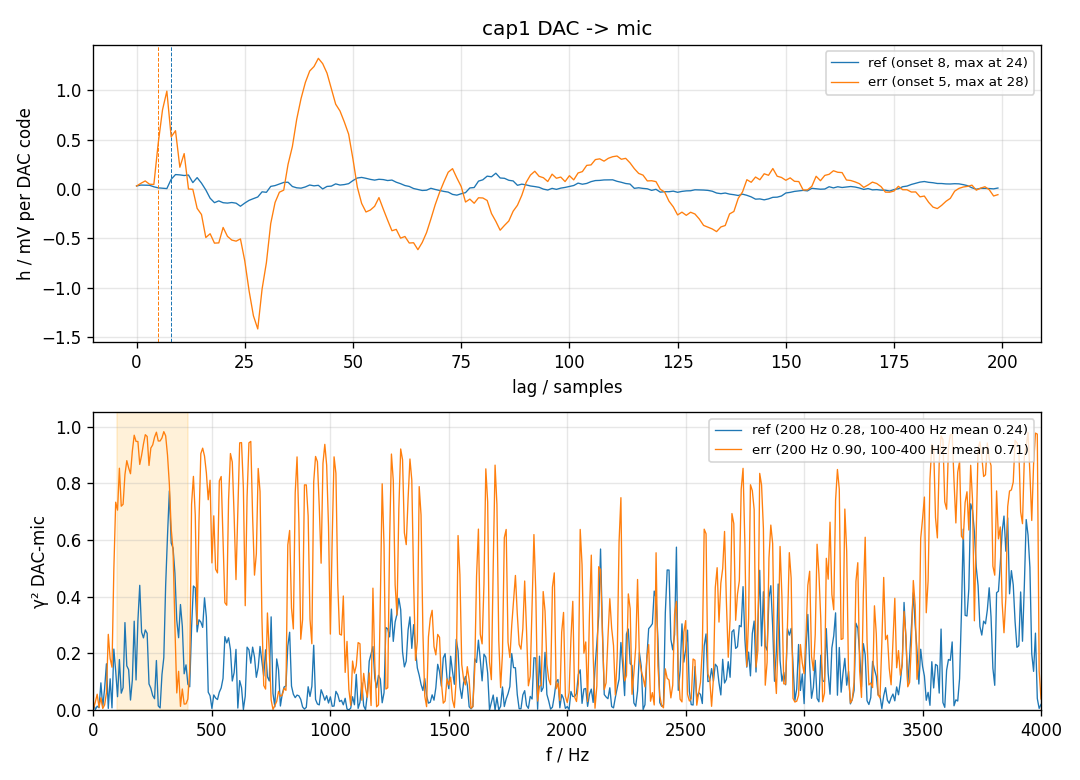
实验记录/20261110_212446_p4delay/cap1_dac.png
