COSMOS-LYX/DuctANC/实验记录/20261110_102024_p0test/1_spk_on.png

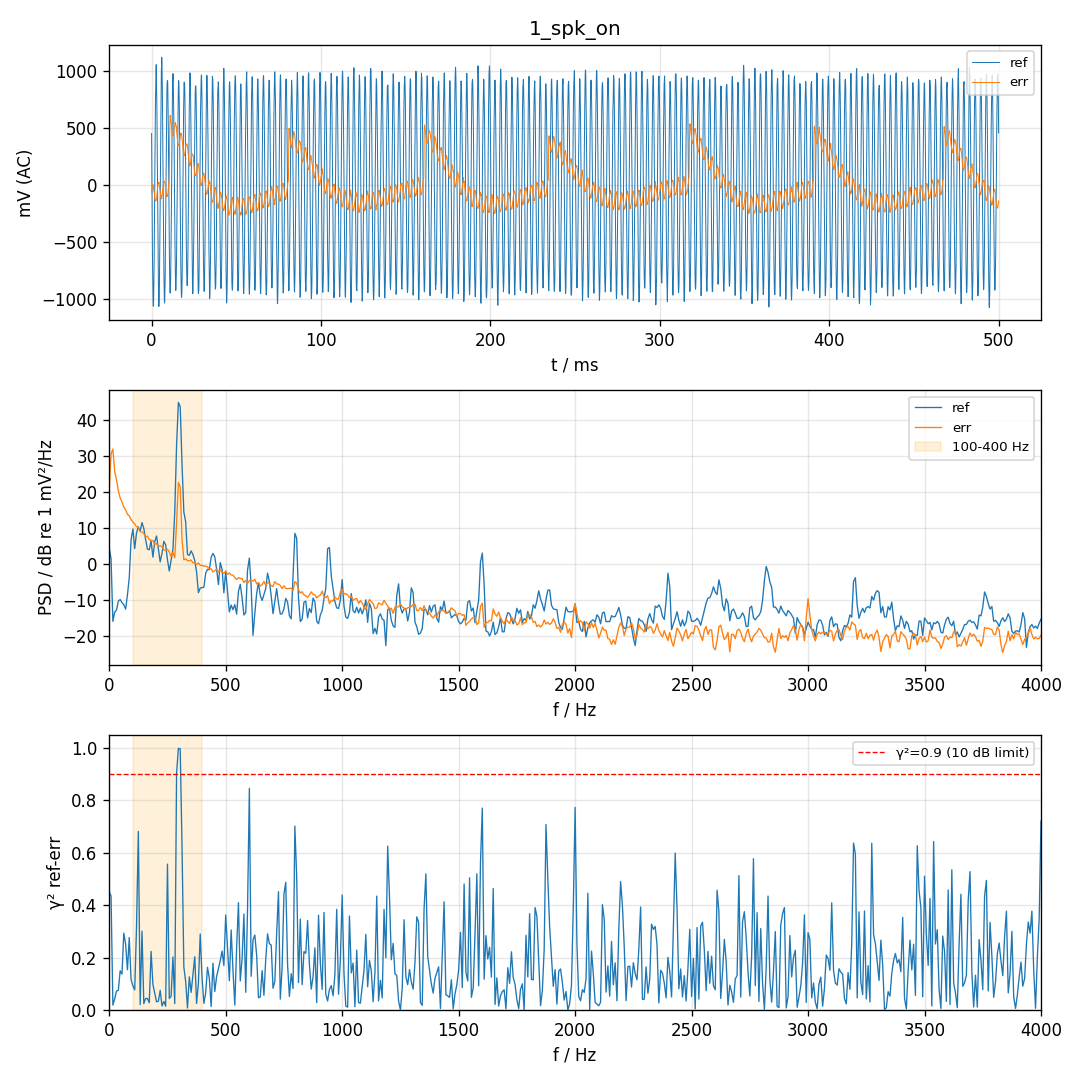
实验记录/20261110_102024_p0test/1_spk_on.png
