COSMOS-LYX/DuctANC/实验记录/20261110_102024_p0test/2_spk_unplugged.png

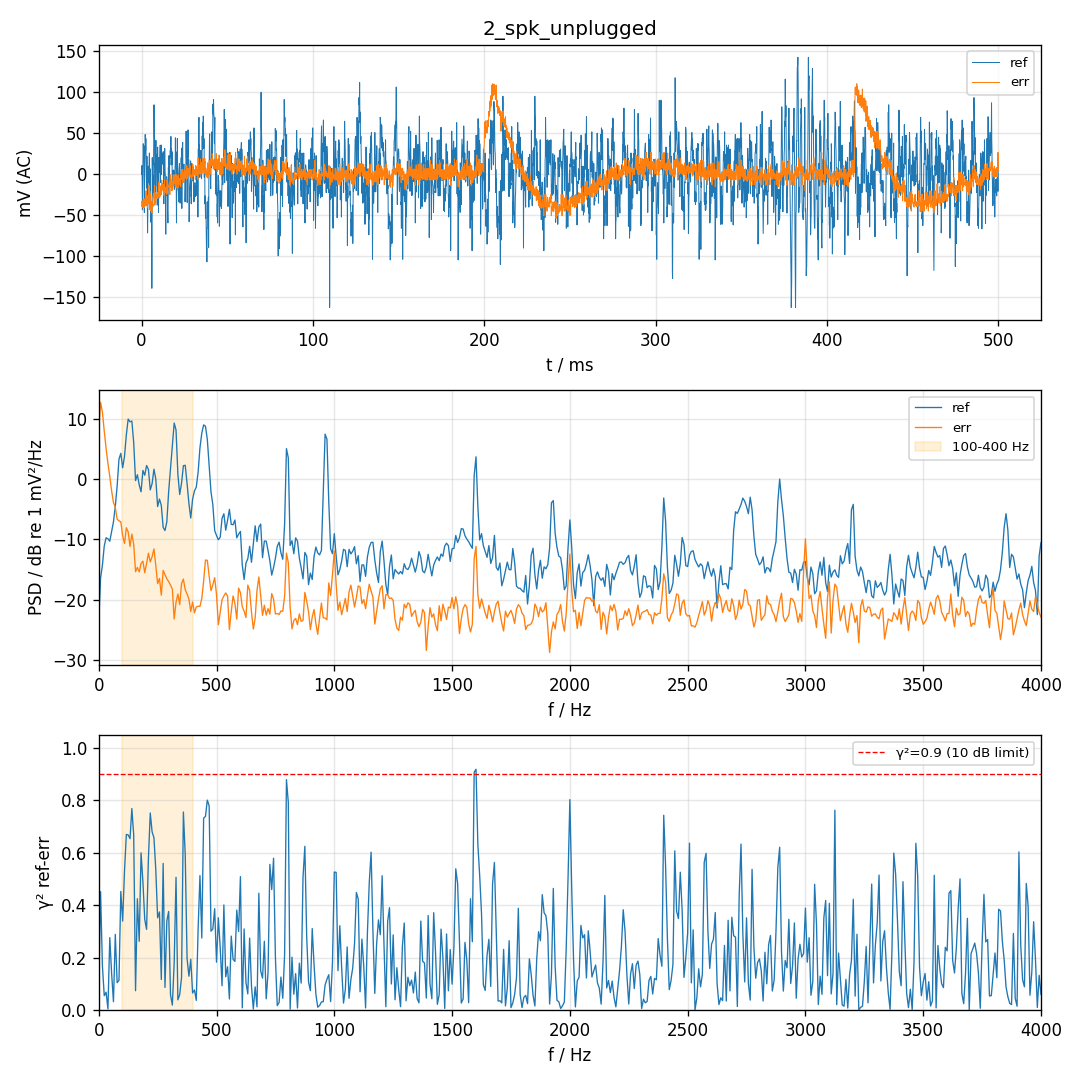
实验记录/20261110_102024_p0test/2_spk_unplugged.png
