COSMOS-LYX/DuctANC/实验记录/20261110_152500_p0test/0_quiet.png

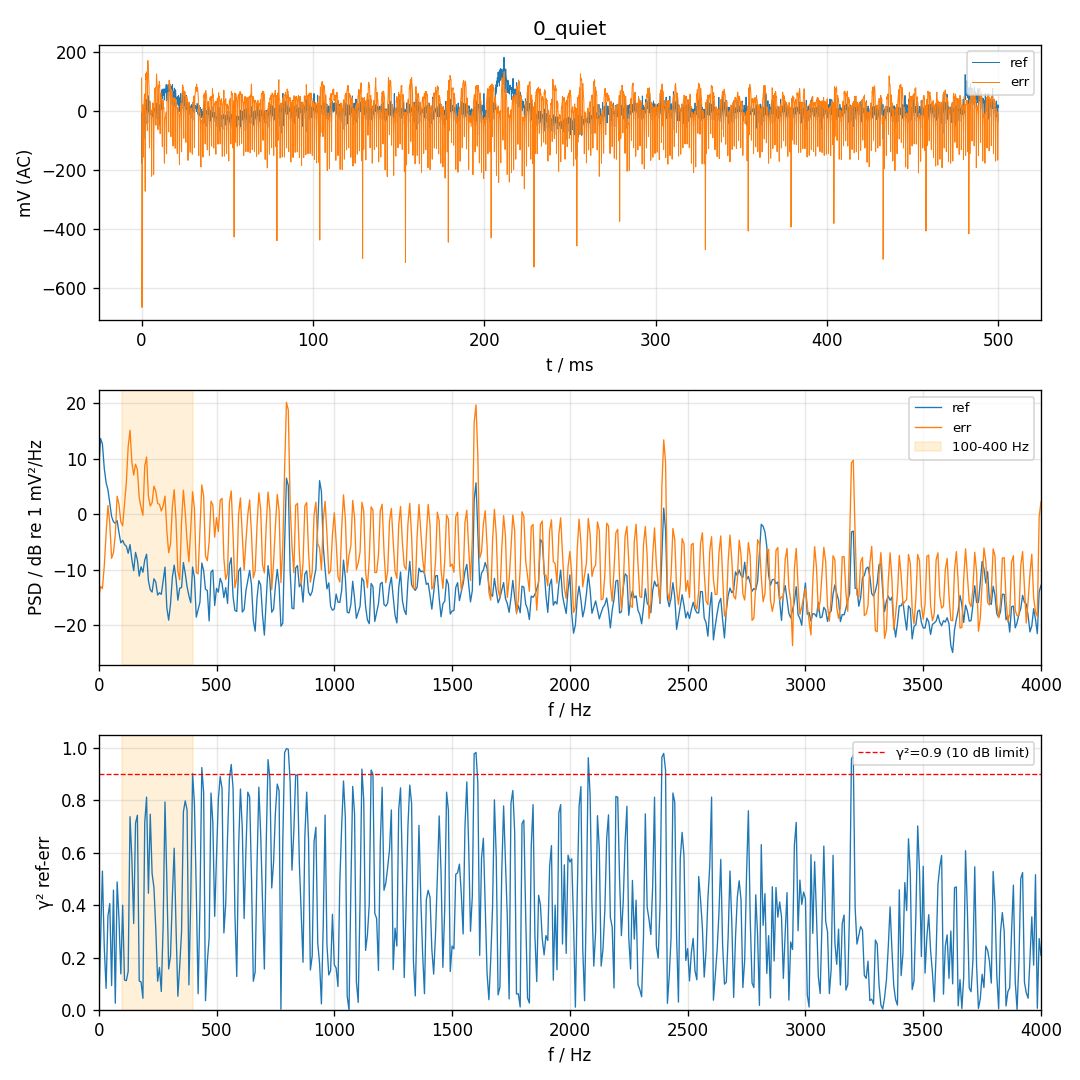
实验记录/20261110_152500_p0test/0_quiet.png
