COSMOS-LYX/DuctANC/(commit log)

2026-11-09 Initial commit: Duct ANC diploma project docs, firmware and host tools
2026-11-10 Record the first-stage 200 Hz feedforward result.
    The board now runs sample-by-sample FxNLMS. An 8 s trial at mu 0.005 lowered the error-mic tone from 271 mV to an 84 mV median, about 10 dB, while the null still wandered and the output clamp stayed busy.
    [analysis.py, anc.c, anc.h, anc_coeff.py, anc_delay.py, anc_demo.py, anc_p4.py, anc_run3.py]
